kapilnaidu1/phys39-naidu-cohen/data/module_02/README.txt

Module 2 data files.

part3_hbridge_motor.txt
    Records from Part 3 of Module 2: trim pot -> PWM -> BTS7960 H-bridge
    -> DC motor. Contains the computed PWM timebase, the direction
    symmetry test at four fixed knob settings, the speed sweep plateaus
    read off the Serial Monitor with the predicted pulse widths, a note
    on the double quantization in the ADC-to-PWM chain, and what the
    BK Precision 2120B analog oscilloscope traces do and do not
    establish. Produced by arduino/module_02/trimpot_hbridge/trimpot_hbridge.ino
    with maxDuty = 255.
