kapilnaidu1/phys39-naidu-cohen/data/module_03/README.txt

Module 3 data files.

Reserved for the C3 raw data file: the CSV written by the Python strip
chart, with column headings time_s, temperature_C, pwm, heat_cool, plus
the labeled heating and cooling serial records.
