kapilnaidu1/phys39-naidu-cohen/data/module_01/README.txt

Module 1 data files.

ave_data.txt
    Raw Serial Monitor capture from code/module_01/averaging_compare.ino,
    Parts 3C and 3D. Potentiometer parked on the ADC code 863/864 boundary.
    Contains the complete 100-point Ave1 block, the complete 100-point
    Ave1000 block, and the timing lines that bracket them, plus the
    code-512 observation discussed in section 4.5 of the evidence note.
