kapilnaidu1/phys39-naidu-cohen/data/module_08/bench_log_2026-10-28.md

# Bench log, 28 October 2026: rod instrument, first step and steady profile

Naidu. `python3 python/rod_pi_logger.py`, sketch
`arduino/module_08/rod_tec_multichannel`, PI Kp 12, Ki 0.2, anti-windup on,
PWM limit 255. Base thermistor on A0, rod thermistors R1 to R5 on A1 to A5,
100 kOhm fixed resistors. Calibration offsets from
26 October (`calibration_rod_run_20261026_112627.csv`). Times are Arduino
seconds within each file.

## Runs

| File | What happened |
|---|---|
| `rod_run_20261028_090604` | 213 s, control off, room readings while the sensors settled. |
| `rod_run_20261028_091129` | Baselines noted at 85 s and 303 s. Control was ticked on at 40 °C three times (486, 494, 514 s) and switched off within 1 s each time: the base reading dropped out (86 rows with no base value) and the logger turns control off when the base reading is unusable. Logger restarted. |

Earlier that morning the base thermistor had been in a rod hole; it was moved
back into the plate hole below the foam before the main run.
| `rod_run_20261028_092033` | The main run, below. |

## Run 092033 (started 09:20:33)

| Arduino time (s) | Event |
|---|---|
| 13 | note "baseline"; control off, all sensors at room temperature |
| 87 | PI on, setpoint 40 °C (old tape order, see below) |
| 602 | control off; first step not stationary (R5 still rising) |
| 1319 | note "baseline 3"; rod re-taped so R1 is in the lowest rod hole (course Part 2) |
| 1544 | PI on, setpoint 20 °C |
| 1608 | note "hold 20 C, new order: R1 lowest hole (x=0), R2-R5 up the rod" |
| 2440 | note "cal check 20 C, rod drifting 0.02-0.05 C/min" |
| 2556 | setpoint 20 → 45 °C (note typed at 2567) |
| about 3440 | hands and a ruler near the rod while measuring the hole spacing; R1 dipped 0.4 °C (note at 3645) |
| 4647 | control off, logger closed |

**Sensor maps.** 0 to 602 s used the old tape order:
`sensor_map_rod_run_20261028_092033.csv`. From 1319 s: `sensor_map.csv` (R1
in the first rod hole = x = 0, R2 to R5 up the rod). The `_meta.json` of this
run holds the sensor map as it was at 09:20 (positions blank), so the two
files above are the record.

**Room temperature.** 13 to 87 s: the five rod channels read 21.03 °C (sd
0.02 °C) after offsets; base 20.98 °C. No room reading at the end.

**Positions.** Measured with a tape after the run: the holes holding R1 to
R5 are 1 in (25.4 mm) apart, ±1 mm. The farthest hole is about 4 in beyond R5
and R1's hole to the rod top about 11 in (rough). **To do: rod diameter with
calipers, a room-temperature reading at the end of a hold, photograph.**

## Results

- Step response: `data/module_08/step_rod_run_20261028_092033_t1319-4646.txt`
  and the figure of the same name. Non-oscillatory base step (peak
  45.07 °C); R1 to R5 rise 17.5, 16.3, 14.8, 13.6 and 12.8 °C with arrival
  times 6, 10, 15, 21 and 28 s.
- Steady profile (last 300 s): m = 4.12 ± 0.07 m⁻¹ (finite, insulated tip, χ²/dof 3.5),
  θ5/θ1 = 0.74. The course placement target θ5 ≤ θ1/e is **not met**, and
  the fit predicts 0.60 at the farthest hole. Details:
  `docs/module_notes/module_08_stationary_fin.md`.
- Raised with Prof. Fraden: spread the sensors to the farthest hole and accept
  about 0.6, or change the set-up (insulation or air around the rod).
