kapilnaidu1/phys39-naidu-cohen/data/module_06/bench_log_2026-10-19.md

# Bench log, 19 October 2026: foam box off and on

Naidu. One GUI session, `python3 python/tec_pi_control_gui.py`, with
`arduino/module_06/tec_pi_safety` on the board (readings every 0.56 s, as on 13
and 14 October). File:
`pi_run_20261019_105852.csv` (GUI launched 10:58:52). Water loop and 12 V
supply on. Anti-windup on, PWM limit 255, run label 0 throughout. Times below
are GUI time (the `time_s` column).

Purpose: the foam-removal experiment designed in
`docs/module_notes/module_06_oral_review.md`, section 6. The plan was three
blocks (foam off, on, off); only two were run because of time.

| GUI time (s) | Foam | Setting | Notes |
|---|---|---|---|
| 0 to 40 | off | control off | plate 22.3 °C at the start, rising slowly |
| 40 to 315 | off | PI, Kp 12, Ki 0.2, 30 °C | |
| 316 to 678 | off | PI, 45 °C | |
| 678 to 1028 | off | control off | passive cool-down, about 350 s |
| 1028 to 1338 | off | P, Kp 2, 35 °C | |
| 1338 to 1401 | fitted | control off | foam box put on |
| 1401 to 1612 | on | PI, Kp 12, Ki 0.2, 30 °C | |
| 1613 to 1737 | on | PI, 45 °C | shorter than planned (about 2 min) |
| 1738 to 1891 | on | control off | cool-down, shorter than planned (about 150 s) |
| 1891 to 2220 | on | P, Kp 2, 35 °C | |
| 2220 | on | control off, GUI closed | third block (foam off) not run |

Analysis: `python3 python/foam_experiment_analysis.py`, output in
`data/module_06/foam_experiment_output.txt`.
