kapilnaidu1/phys39-naidu-cohen/data/module_06/bench_log_2026-10-13.md

# Bench log, 13 October 2026

## Setup

- Uploaded `arduino/module_06/tec_pi_safety`. Boot banner confirms 1000 ADC
  readings per temperature. Readings arrive every 0.56 s (median dt 0.560 s,
  range 0.560 to 0.610 s in the run file), not 0.50 s.
- Plate at PWM 0 before any drive: 22.38 C at first upload, 22.0 C after the
  second reset. Module 4 measured 21.54 C.
- TEC on-state voltage: **not measured.** The multimeter gave no reading at
  PWM 255. The instructor checked the setup and said to use the 12 V maximum
  and move on to the experimental runs. Simulations use V_TEC = 12 V on that
  basis.
- While trying to measure it, COOL 255 was held for about 37 s: the plate went
  from 22.00 C to -1.58 C, then recovered passively for 18.6 s to 5.84 C.
  Raw output: `serial_2026-10-13_cool255_burst.txt`.

## Instructor

- Reviewed the PI code in `python/tec_pi_control_gui.py`.
- TEC voltage: use 12 V (above).
- Said not to redo the Module 4 measurements: keep the existing tau, which
  came from 500-sample data, and use 1000-sample averaging from now on.

## Goldilocks runs

All six in `pi_run_20261013_094149.csv`, one GUI session (`python/tec_pi_control_gui.py`).
Same for every run: setpoints 30 and 35 C, PWM limit 255, anti-windup on,
integral zeroed before each run. Each run starts from wherever the plate was
after control was switched off, settles at 30, steps to 35, steps back to 30.
"Settled" is the mean of the last 30 s of each stage.

| Run | Mode | Kp | Ki | Start (C) | Settled at 30 / 35 / 30 (C) | Peak or dip |
|---|---|---|---|---|---|---|
| 1 | P | 2 | 0 | 21.15 | 25.76 / 28.25 / 25.76 | none |
| 2 | P | 16 | 0 | 23.41 | 29.05 / 33.52 / 29.12 | none |
| 3 | P | 64 | 0 | 23.94 | 29.74 / 34.59 / 29.76 | 31.55, 36.28, dip 29.69; rings |
| 4 | PI | 12 | 0.05 | 23.08 | 29.66 / 34.71 / 30.08 | none; still creeping after 300 s |
| 5 | PI | 12 | 0.2 | 24.72 | 29.97 / 35.02 / 29.93 | 35.04, dip 29.91 |
| 6 | PI | 12 | 1.0 | 24.95 | 30.00 / 35.00 / 30.00 | 30.59, 35.71, dip 28.70 |

Run 3 hit the +255 and -255 limits briefly on each step (11 saturated rows).
No other run saturated.

## Not part of the six runs

From 3750 s to 3941 s, still labelled run 6, the instructor had us try
Ki = 2, 5 and 10 at Kp = 12 as a spot check. These rows are identified by their
`ki` column and are not retained Goldilocks data. Largest swings: 37.99 C at
Ki = 5 after a step to 35, and 25.51 C at Ki = 10 after a step to 30.
