kapilnaidu1/phys39-naidu-cohen/docs/assessments/a2_open_loop_tec.md

# A2: TEC Heating and Cooling Analysis

**Team:** Naidu / Cohen
**Due:** Wednesday 7 October 2026, 6:00 PM (moved from 5 October by email,
30 September)
**Submit:** `docs/A2_Naidu_Cohen.pdf`, two pages, each of us uploads it
separately to Moodle
**Repository file:** none required. No Git checkpoint for this one.

Working note: [`docs/module_notes/module_04_open_loop_tec.md`](../module_notes/module_04_open_loop_tec.md)

> **Do NOT include** C2/C3 circuit sketches, apparatus descriptions, the
> safety demonstration, or code documentation. Those live in the module note
> and stay there. A2 is analysis only.

The assignment was restructured on 30 September. It now asks for **six numbered
sections using the course page's own headings**, and the 100 to 150 word
conclusion is **no longer required**. The PDF follows those headings exactly,
including the two sections both numbered Part 5.4, since both come from Part 5
subsection 4 of the module.

| Section heading in the PDF | Rubric | Points |
|---|---|---|
| Part 4: Combined graph and fits | items 1-2 | 2 |
| Part 5.1: Measured slopes | items 1-2 | (same 2) |
| **Part 5.2: PWM and the slope-ratio model** | item 3 | **3** |
| Part 5.3: Laird data-sheet calculation | item 4 | 2 |
| Part 5.4: Compare the ratios | items 5-6 | 2 |
| Part 5.4: Passive conduction | items 5-6 | (same 2) |
| Concise, legible, complete | | 1 |

The derivation carries the most weight of any single item.

---

## 1. The graph *(2 pts, shared)*

Part 4 figure: steady-state temperature versus **signed PWM**, heating red
and cooling blue as separate data sets, **with fitted lines over the ranges
used**, labelled axes, units, and a caption stating how steady state was
chosen.

Generated by `python/plot_open_loop_calibration.py` into
`docs/figures/module_04/`.

*Status: waiting on Part 3 data.*

## 2. Slopes, units, ratio *(2 pts, shared)*

| | value | fit range | R squared |
|---|---|---|---|
| m_h | TO RECORD C per PWM count | | |
| m_c | TO RECORD C per PWM count | | |
| r = m_h / m_c | TO RECORD | | |

Note any visible curvature.

## 3. The derivation *(3 pts, the heaviest item)*

Three things, all required:

**(a) PWM average-current proof.** From the definitions of the averages over
one period, with current I for D*tau and zero otherwise, show
`<I> = D I` and `<I^2> = D I^2`. Explain why `<I^2>` is not `<I>^2`, and
connect it to the measured susceptibility: Peltier follows `<I>` and Joule
follows `<I^2>`, both linear in D under PWM, so the susceptibility is
approximately constant and the graph roughly straight.

**(b) Steady-state slope derivation.** From `C dT/dt = Q_TEC - G(T - T0)` at
`dT/dt = 0`, with `Q_TEC = d Qp + |d| Qj`, obtain

```
dTh/dd = (Qp + Qj)/G        dTc/dd = (Qp - Qj)/G
```

and hence, the 1/255 cancelling from the ratio,

```
Qj/Qp = (r - 1)/(r + 1)
```

**(c) Numerical result.** Evaluate `Qj/Qp` from the measured r. Check: r = 2
gives exactly 1/3.

Full working is in section 5 of the module note.

## 4. Laird data sheet *(2 pts)*

Source: **Laird CP14-127-045-L2-W4.5**, MFG part 58910-501, SPECIFICATIONS
table, **Hot Side Temperature = 27.0 C** column.

| Quantity | Value | What it means, and the condition attached |
|---|---|---|
| `R_M` | **1.50 ohm** | Ohmic resistance of the 127 couples in series. Quoted at Th = 27 C; it rises with temperature (1.56 at 35 C, 1.68 at 50 C on the same sheet) |
| `I_max` | **8.6 A** | The current that produces the **largest temperature difference**, not a safety ceiling. Condition: I at dT_max |
| `Qc_max` | **71.3 W** | Most heat the cold face can absorb. Condition: **dT = 0**, so the module is pumping with no temperature difference to fight |
| `dT_max` | **70.5 C** | Largest temperature difference the module can sustain. Condition: **Qc = 0**, no heat load at all |

`Qc_max` and `dT_max` sit at opposite ends of one trade-off: maximum pumping
needs zero temperature difference, maximum difference needs zero load. The
module never delivers both.

### Calculation

At the data-sheet condition dT = 0, so the conduction term vanishes. The
symmetric model puts half the Joule heat on each face:

```
Qj_max = 0.5 * I_max^2 * R_M
       = 0.5 * (8.6 A)^2 * 1.50 ohm
       = 55.47 W

Qp_max = Qc_max + Qj_max
       = 71.3 W + 55.47 W
       = 126.77 W

r_Laird,max = (Qp_max + Qj_max) / (Qp_max - Qj_max)
            = (126.77 + 55.47) / (126.77 - 55.47) W/W
            = 2.556
```

### Data-sheet check

**Verified against the data sheet, 5 October.** All four values, plus
V<sub>max</sub> = 13.9 V and the 35 and 50 &deg;C resistances, were read again
from the course-hosted PDF and match. The SPECIFICATIONS table is on **page
3** of the three-page sheet.

**A cross-check that was here has been withdrawn.** It computed a Seebeck
coefficient from V<sub>max</sub> = I<sub>max</sub>R<sub>M</sub> +
S&middot;&Delta;T<sub>max</sub>, using R<sub>M</sub> = 1.50 &Omega;. But 1.50
&Omega; is the resistance with the whole module at 27 &deg;C, and
V<sub>max</sub> is quoted at &Delta;T<sub>max</sub>, where the cold face is
near &minus;44 &deg;C and the module averages about &minus;8 &deg;C. The sheet
gives no resistance at that temperature, and the answer depends heavily on it:
1.50 &Omega; gives S = 0.014 V/K, while a straight-line extension of the
sheet's own 27 to 50 &deg;C trend down to &minus;8 &deg;C (an assumption, for
illustration only) gives 1.22 &Omega; and S = 0.048 V/K. A check that moves by
a factor of three with an unknown input cannot confirm anything, and the
earlier claim that 0.014 V/K was "reasonable" for 127 couples was not
supported.

## 5. Comparison *(part of 2 pts with item 6)*

| | r | Qj/Qp |
|---|---|---|
| **measured** | **2.771** | **0.470** |
| **Laird, at I_max** | **2.556** | **0.438** |
| ratio | 1.084 | |

**Agreement to 8%**, which is closer than this comparison has any right to be,
and the write-up should say so rather than claim a prediction confirmed.

**Why they should not be expected to match.**

- **D = 1 does not mean I = I_max.** Full duty only means the bridge is
  continuously on. The actual current is set by the supply voltage, the
  H-bridge drop, wiring resistance, `R_M` and the module's own back-EMF. The
  supply is rated 12 V with no adjustable current limit; its measured voltage
  was not written down. 12 V across R_M = 1.50 ohm gives **at most about
  8.0 A**, 7% below I_max, and less once the other drops are included. So full
  duty does not reach I_max, but the margin set by the supply alone is small,
  and **the bench current was never measured**. An earlier version said "well
  under 8.6 A" using a 1.6 ohm figure taken from the withdrawn Seebeck
  cross-check; that was not supported.
- **PWM, not steady DC.** Our current is chopped. Section 3a shows the
  cycle averages are `<I> = DI` and `<I^2> = DI^2`, so the Peltier and Joule
  contributions scale together with duty; the data sheet assumes a steady
  current.
- **Finite dT.** The data-sheet relation is stated at `dT = 0` where
  conduction through the module is zero. Our plate ran 25 C above and 12 C
  below ambient, where that term is not negligible and is lumped into `G`.
- **Material properties move with temperature.** The same sheet shows `R_M`
  rising from 1.50 to 1.68 ohm between 27 and 50 C.
- **One slope fitted to each branch.** R^2 is 1.0000 and 0.9989, so this is a
  small effect here, but the fit still averages over a range where the
  coefficients are not strictly constant.

**Direction of the difference.** Our `Qj/Qp` is the larger. That is what you
expect when running below `I_max`: Peltier pumping falls linearly with
current while the Joule term falls as the square, but the *ratio* `Qj/Qp`
goes as `I`, so operating below `I_max` should actually reduce it. The fact
that ours is instead slightly higher points at the extra dissipation our
model lumps into the object face that the data sheet does not carry, such as
lead and contact resistance in series with the module.

## 7. Conclusion, 100 to 150 words *(1 pt with formatting)*

> Steady-state temperature is linear in signed PWM on both branches
> (R^2 = 1.0000 heating, 0.9989 cooling), which is what the PWM averages
> predict: Peltier transport follows `<I> = DI` and Joule heating follows
> `<I^2> = DI^2`, so both scale with duty and the susceptibility stays
> constant. Had `<I^2>` gone as `D^2`, the branches would curve. The two
> slopes differ by a factor r = 2.771 because reversing the current reverses
> Peltier pumping but not Joule heating: the two add when heating and oppose
> when cooling, giving `Qj/Qp = (r-1)/(r+1) = 0.470`. Passive conduction
> enters both branches through the same `G` and cancels from the ratio, so it
> sets how steep the lines are but cannot make them unequal. The Laird
> maximum-current figures predict r = 2.556, within 8% despite describing a
> steady-DC, zero-dT condition our apparatus never reaches.

**146 words.** Edit freely; it's meant as a starting draft, not a final voice.

Every claim in it traces to something in the paper above: the two R^2 values
from item 1, r and Qj/Qp from items 2 and 3, the cancellation argument from
item 6, and the 8% from item 5.

## Assembly

1. Fill `data/module_04/steady_state.csv`
2. `python3 python/plot_open_loop_calibration.py` from the repo root
3. Read the Laird values off the data sheet
4. `python3 python/build_a2_pdf.py`, which writes `docs/A2_Naidu_Cohen.pdf`
5. Both of us upload it to Moodle separately
