kapilnaidu1/phys39-naidu-cohen/docs/A2_Naidu_Cohen.pdf

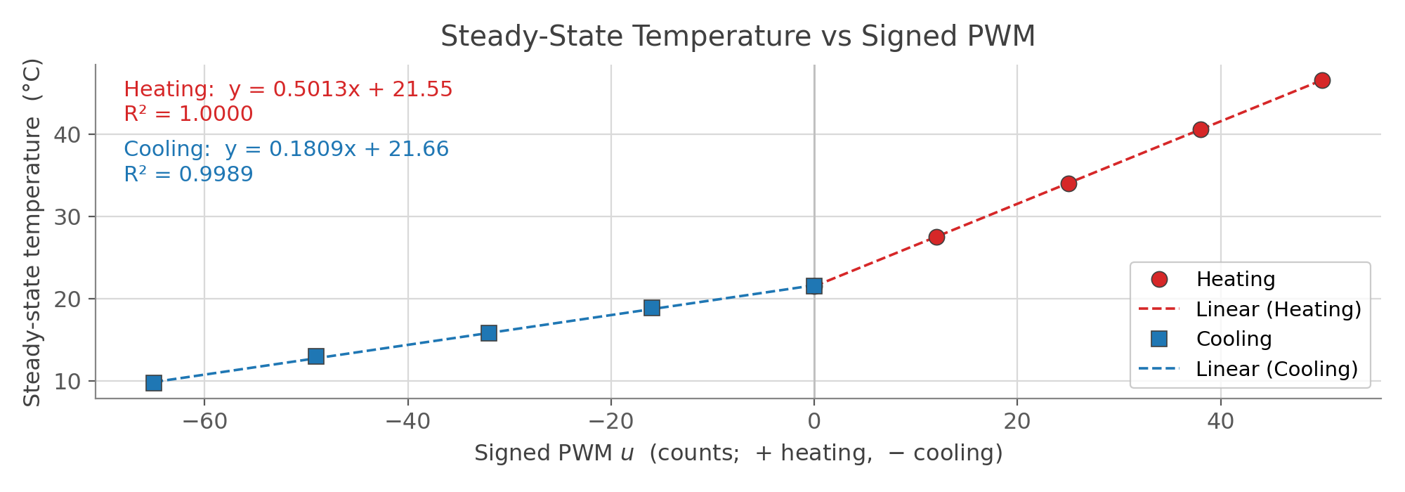
[picture p46: figure]

1 / 2

# A2: TEC Heating and Cooling Analysis

Assessment code: A2
Team members: Kapil Naidu and Samuel Cohen
Date: September 30, 2026 (data collection)
Repository: https://github.com/kapilnaidu1/phys39-naidu-cohen, branch main

## Part 4: Combined graph and fits

Figure 1. Steady-state plate temperature against the signed PWM command u, positive for heating and negative for cooling, with both branches on one graph. Ten points, five per branch, about the zero-command temperature T0

= 21.54 °C. Each trendline is drawn only over the PWM range used for its own fit: u = 0 to +50 counts for heating, u = −65 to 0 counts for cooling. Steady-state criterion: after each step the trace was watched for about three driven time constants (τ ≈ 70 s) plus one further minute, and the point was accepted once its net drift over that minute was no larger than the measured noise of 0.16 °C peak to peak. Points that had not fully arrived are reported as the asymptote of an exponential fit, and data/module_04/steady_state.csv records which.

## Part 5.1: Measured slopes

Branch | Susceptibility dT/du | Fit range (counts) | 2 R | Intercept
Heating | mh = 0.5013 °C per PWM count | u = 0 to +50 | 1.0000 | 21.55 °C
Cooling | mc = 0.1809 °C per PWM count | u = −65 to 0 | 0.9989 | 21.66 °C

Against signed u both slopes are positive, so the cooling entry is already the magnitude |χ

T,c|. The ratio is r = mh
/ mc

=
0.5013 / 0.1809 = 2.771, dimensionless because both slopes carry the same units.
Curvature and choice of fit range. Neither data set shows visible curvature, so each branch was fitted over its full measured range rather than a restricted sub-range; the ranges above are simply the PWM values used in Part 3. The branches are fitted separately because the slope changes abruptly at u = 0, not because either bends. The intercepts differ by 0.11 °C and the cooling one sits 0.12 °C above T0

, consistent with the room drifting over a two-hour session.

## Part 5.2: PWM and the slope-ratio model

Step 1. The steady-state balance
With C the heat capacity of the object and G the effective passive conductance to the room, C dT/dt = QTEC − G(T − T0

). At
steady state dT/dt = 0, so the individual flows are not zero but their sum is, and G(T − T0

) = QTEC. Taking the two terms in turn: heating, Peltier transport and Joule dissipation both carry heat into the object while conduction carries heat out of it to the cooler room; cooling, Peltier transport carries heat out of the object, Joule dissipation still carries heat into it, and conduction carries heat into it from the warmer room.
Step 2. PWM current averages
Over one PWM period τ the bridge delivers the on-state current I for a time Dτ and zero for the remaining (1−D)τ, with duty D = |u| / 255. Both integrands vanish outside the on-interval, so each integral is just the integrand times Dτ:
<I> = (1/τ) ∫0

τ
I(t) dt = (1/τ) · I · Dτ = D I <I

2
> = (1/τ) ∫0

τ

I²

(t) dt = (1/τ) · I²
- Dτ = D I²

<I

2> is not <I>

2

= D²
I

2
: squaring and averaging do not commute, and for a two-level waveform the two differ by a factor 1/D. Peltier transport follows <I> and Joule heating follows <I

2>, and under PWM both are linear in D, so the susceptibility is constant and the branches are straight. Had the Joule term gone as D² the susceptibility would vary with duty and the branches would curve measurably; the measured R²
of 1.0000 and 0.9989 says they do not. With a DAC supplying a steady current of variable amplitude instead, <I

2> = <I>

2
would hold, so the distinction is a property of PWM.

2 / 2

Step 3. The slope ratio
With signed duty d = u / 255 and D = |d|, Peltier transport reverses with the current and Joule heating does not, so QTEC = d QP

+ |d| QJ
. Substituting each branch into G(T − T0

) = QTEC and differentiating with respect to d: heating, d > 0: G(Th
− T0

) = d(QP
+ QJ
) | → | Th

− T0

= d(QP
+ QJ
)/G | → | dTh

/dd = (QP
+ QJ

)/G
cooling, d < 0: G(T
c

− T0

) = d(QP
− QJ
) | → | T
c

− T0

= d(QP
− QJ
)/G | → | dT
c

/dd = (QP
− QJ

)/G

Both are positive while QP
> QJ

, and the heating one is larger. Since d = u / 255, each measured slope carries the same factor 1/255, and that factor and G are common to both branches, so both cancel from the ratio: r = mh

/m
c

= (QP

+ QJ

) / (QP

− QJ

) | ⇒ | QJ

/QP

= (r − 1)/(r + 1) | check: r = 2 gives 1/3 exactly
r = 2.771: | QJ

/QP

= (2.771 − 1) / (2.771 + 1) = 1.771 / 3.771 = 0.470

Joule heat reaching the object face is 47.0% of the Peltier pumping. Both are heat rates in watts, so the ratio is dimensionless. G cancels from r, which matters because G was never measured.

## Part 5.3: Laird data-sheet calculation

Source. Laird CP14-127-045-L2-W4.5, MFG part 58910-501, from the SPECIFICATIONS table on the first page of the CP14-127-045 data sheet, hot-side temperature Th

= 27.0 °C column.

Quantity | Value | Meaning, and the operating condition attached
RM | 1.50 Ω | Ohmic resistance of the 127 couples in series, quoted at Th = 27 °C and rising to 1.68 Ω at 50 °C
Imax | 8.6 A | The current giving the largest temperature difference, not a safety ceiling. Condition: I at ΔTmax
Qc,max | 71.3 W | Most heat the cold face can absorb. Condition: ΔT = 0, no difference to pump against
ΔTmax | 70.5 °C | Largest sustainable temperature difference. Condition: Qc = 0, no heat load

The last two sit at opposite ends of one trade-off: maximum pumping needs zero temperature difference, maximum difference needs zero load. At the data-sheet condition ΔT = 0, so conduction through the module vanishes and the symmetric model puts half the Joule heat on each face:
Q

J,max = ½ I
max

2
RM

= ½ (8.6 A)²

(1.50 Ω) = ½ (73.96 A²
)(1.50 Ω) = 55.47 W
Q
c,max
= QP,max − QJ,max | → | QP,max = 71.3 W + 55.47 W = 126.77 W
r

Laird,max = (QP,max + QJ,max) / (QP,max − QJ,max) = (126.77 + 55.47) / (126.77 − 55.47) = 182.24 / 71.30 = 2.556

Every quantity above is a heat rate in watts, so rLaird,max is dimensionless and directly comparable with the measured r. Cross-check: Vmax
/Imax

= 13.9 V / 8.6 A = 1.616 Ω, 8% above RM

| | , because at ΔTmax

the module develops a Seebeck back-EMF: Vmax
= Imax

RM

+ S·ΔTmax

| | gives S = 0.0142 V/K, reasonable for 127 bismuth telluride couples. The right rows
were read.

## Part 5.4: Compare the ratios

| r | QJ /QP | Condition
Measured, this apparatus | 2.771 | 0.470 | PWM drive, finite ΔT, current set by the supply and bridge
Laird, at Imax | 2.556 | 0.438 | steady DC at 8.6 A, ΔT = 0
ratio | 1.084 | 1.073 | agreement to 8%

The two agree to 8%, closer than the comparison warrants, since the data-sheet figures describe a condition this apparatus never reaches:
- D = 1 does not mean I = Imax

. Full duty only means the bridge is continuously on. The current is set by the 12 V supply and its limit, the H-bridge forward drop, wiring resistance and RM

, which together hold the bench current well below 8.6 A.
- PWM, not steady DC. The bench current is chopped; the data sheet assumes a steady one.
- Finite ΔT and passive heat paths. The data-sheet relation is stated at ΔT = 0, while the plate ran 25 °C above and 12 °C below ambient. There the module's own conduction and the mounting and air paths are not negligible, and all of them are absorbed into the single G.
- Coefficients move with temperature, and one slope is fitted per branch. RM

rises from 1.50 to 1.68 Ω between 27 and 50 °C, so a single fit averages over a range in which the coefficients are not strictly constant. Direction of the difference. The measured ratio is the larger, yet running below Imax

should reduce QJ
/QP

, since that ratio
scales as I. The opposite sign points to dissipation this model assigns to the object face that the data sheet does not carry, such as lead and contact resistance in series with the module.

## Part 5.4: Passive conduction

When the object is hotter than the room, passive heat flows out of the object. When it is colder, passive heat flows into it. Either way the flow drives the object back toward room temperature, so conduction opposes the TEC on both branches, which is why it enters as −G(T − T0

) with a single positive G. It cannot by itself explain the unequal slope magnitudes. The same G appears in the denominator of both dTh

/dd and dT
c

/dd,
so it sets how steep the branches are, a larger G flattening both, but it cancels exactly from their ratio: a symmetric term cannot produce an asymmetric result. The asymmetry survives only in the numerators, where QJ

is added on the heating
branch and subtracted on the cooling one, because Peltier transport reverses with the current and Joule heating does not.
