kapilnaidu1/phys39-naidu-cohen/docs/figures/module_04/sammy_cohen_tec_run_2026-10-13_segment_slopes.png

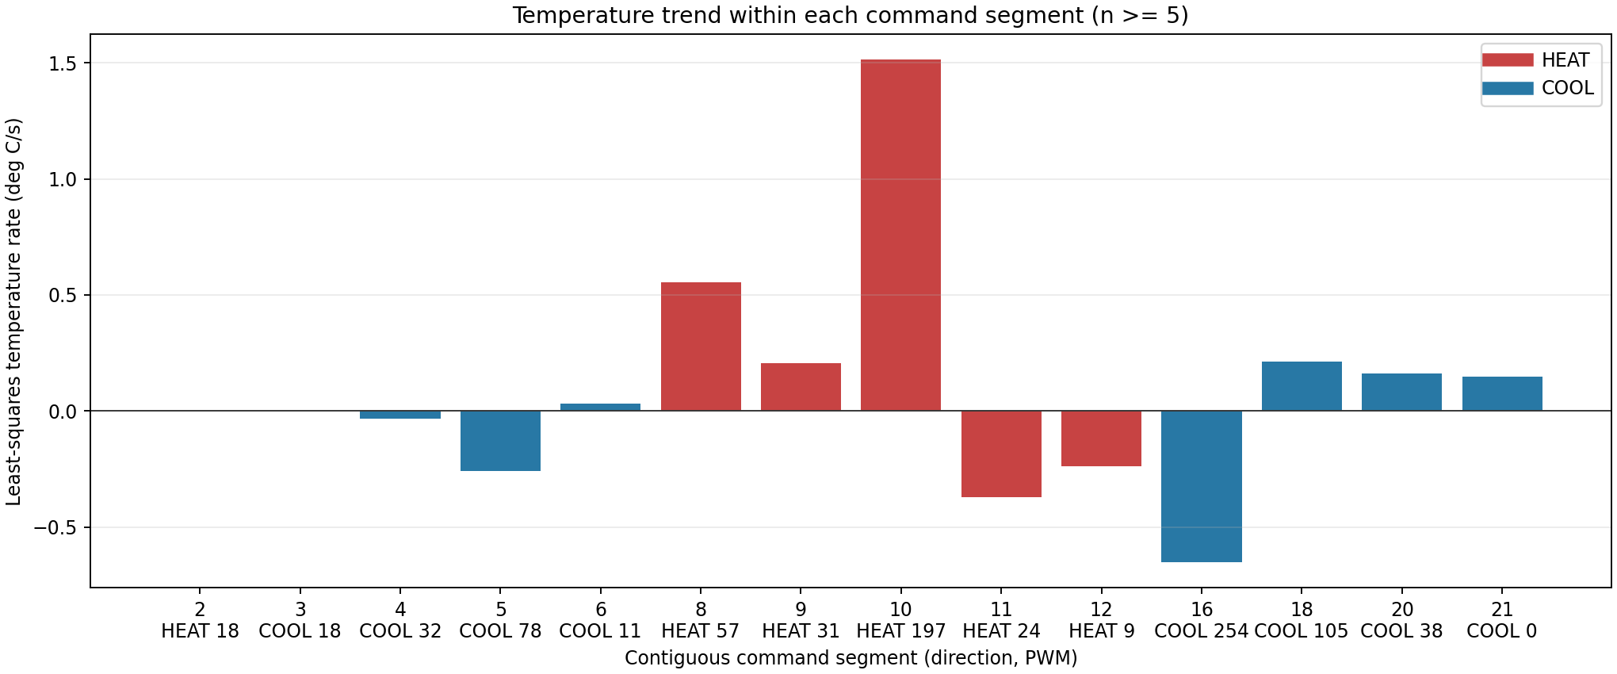
docs/figures/module_04/sammy_cohen_tec_run_2026-10-13_segment_slopes.png
