kapilnaidu1/phys39-naidu-cohen/docs/figures/module_05/p_control_run_2026-10-13_sammy_repeat_timeline.png

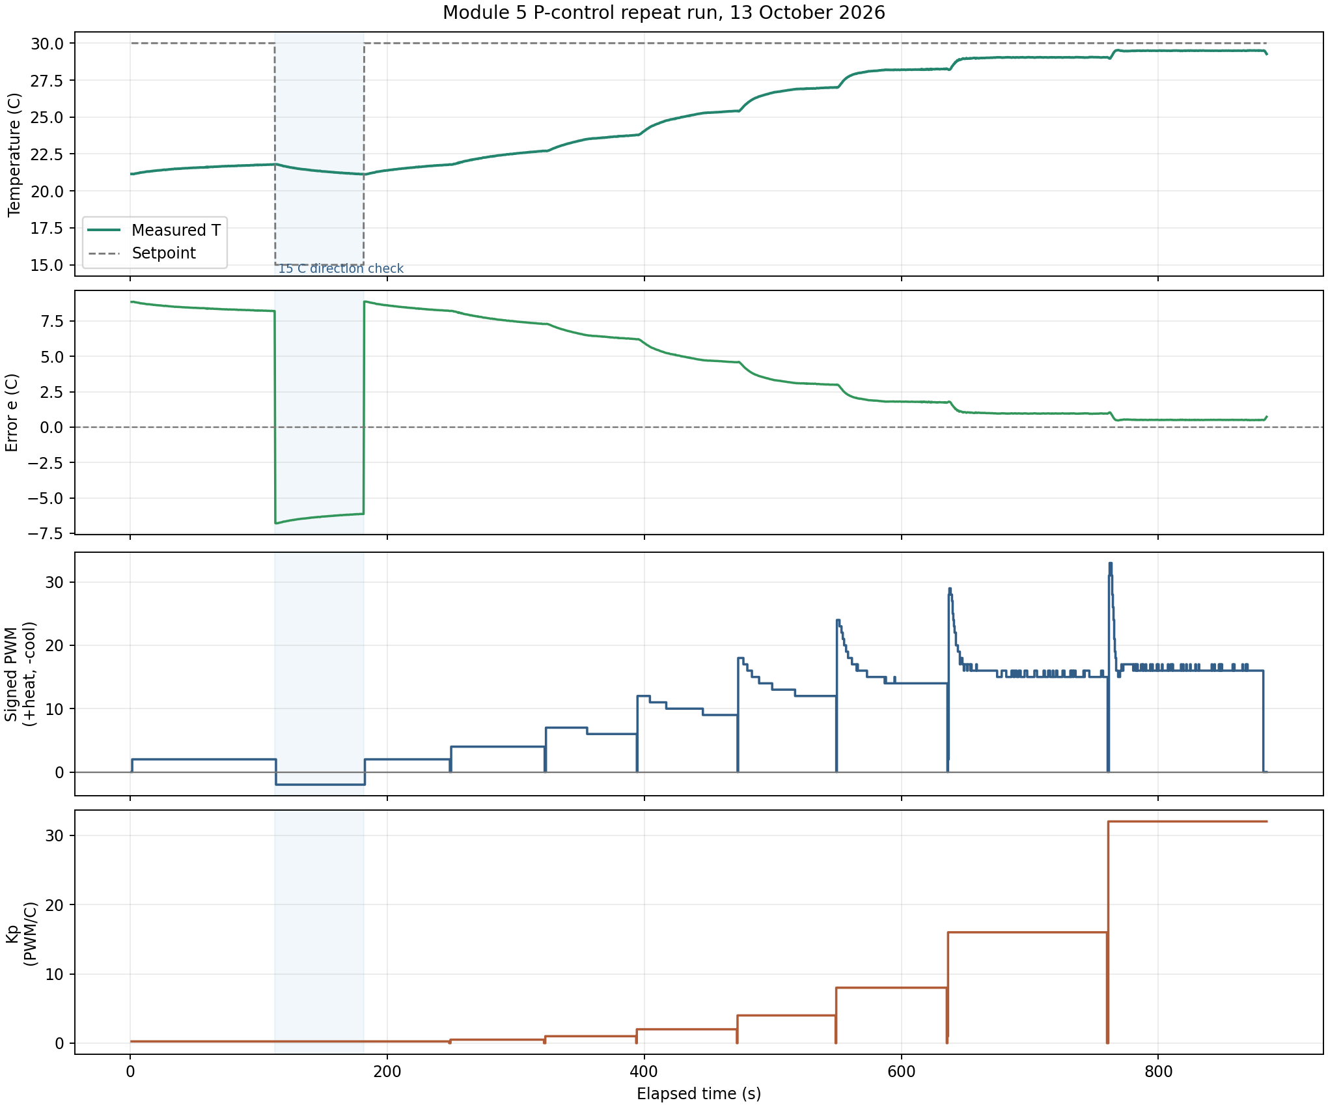
docs/figures/module_05/p_control_run_2026-10-13_sammy_repeat_timeline.png
