kapilnaidu1/phys39-naidu-cohen/docs/figures/module_05/p_control_traces.png

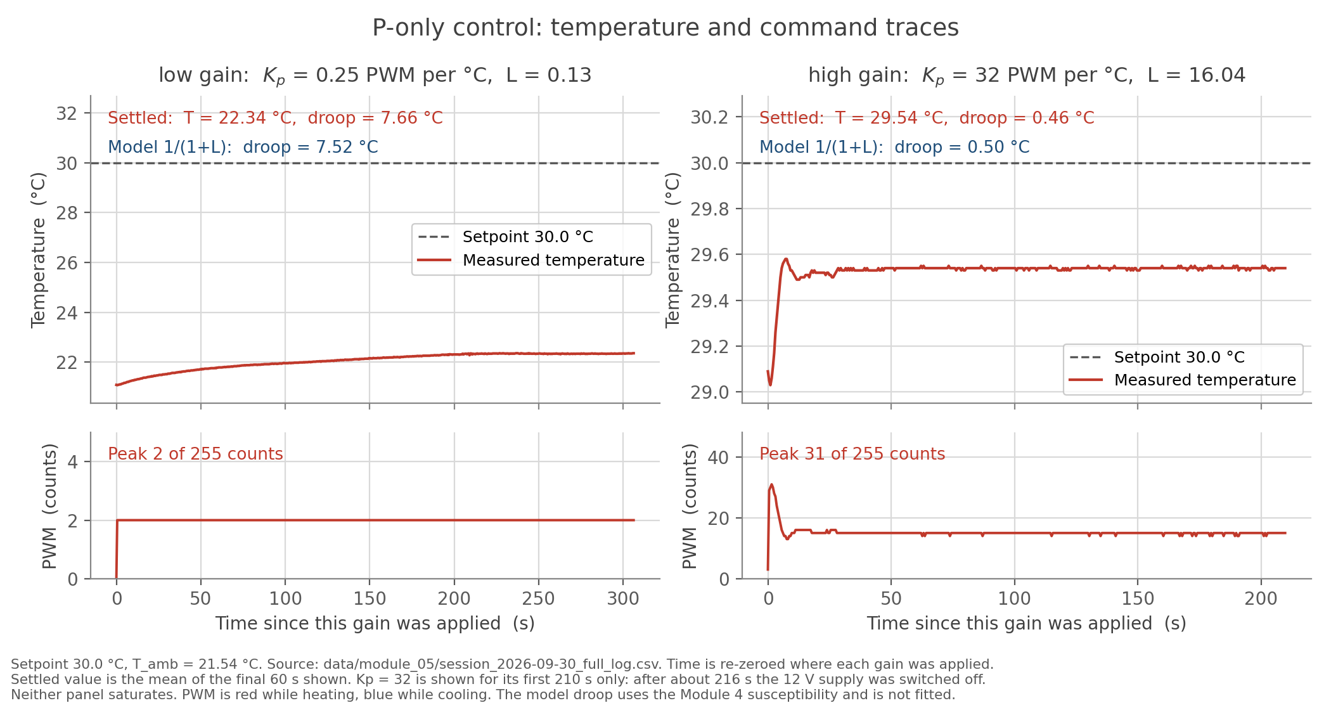
docs/figures/module_05/p_control_traces.png
