kapilnaidu1/phys39-naidu-cohen/docs/figures/module_06/goldilocks/run1_p_kp2.png

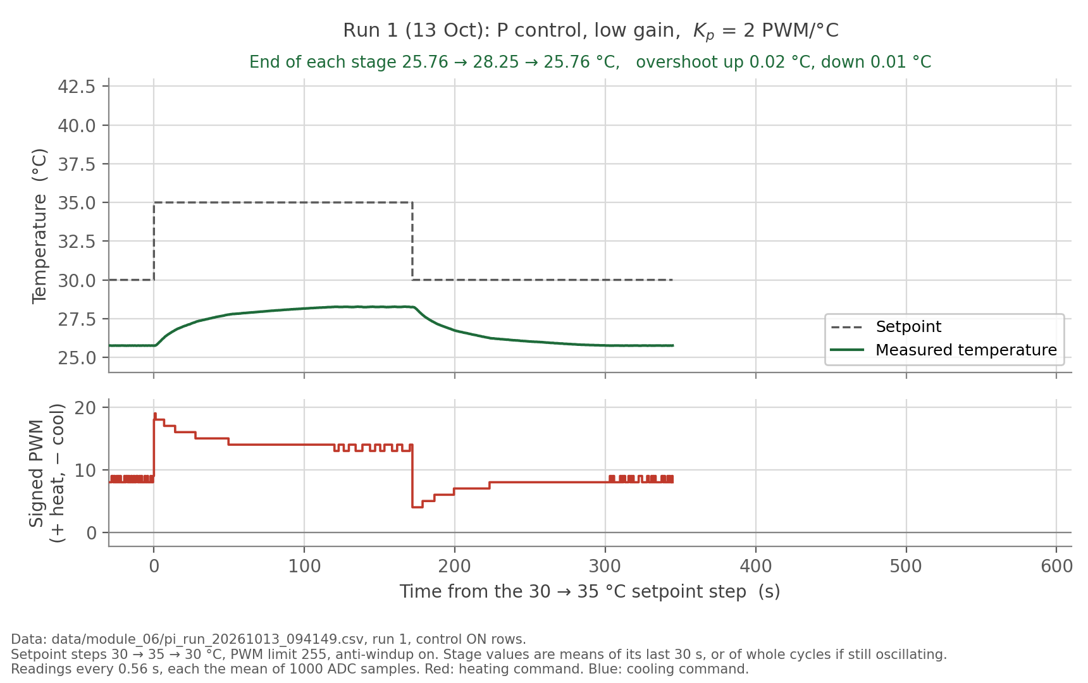
docs/figures/module_06/goldilocks/run1_p_kp2.png
