kapilnaidu1/phys39-naidu-cohen/docs/figures/module_06/goldilocks/run2_p_kp16.png

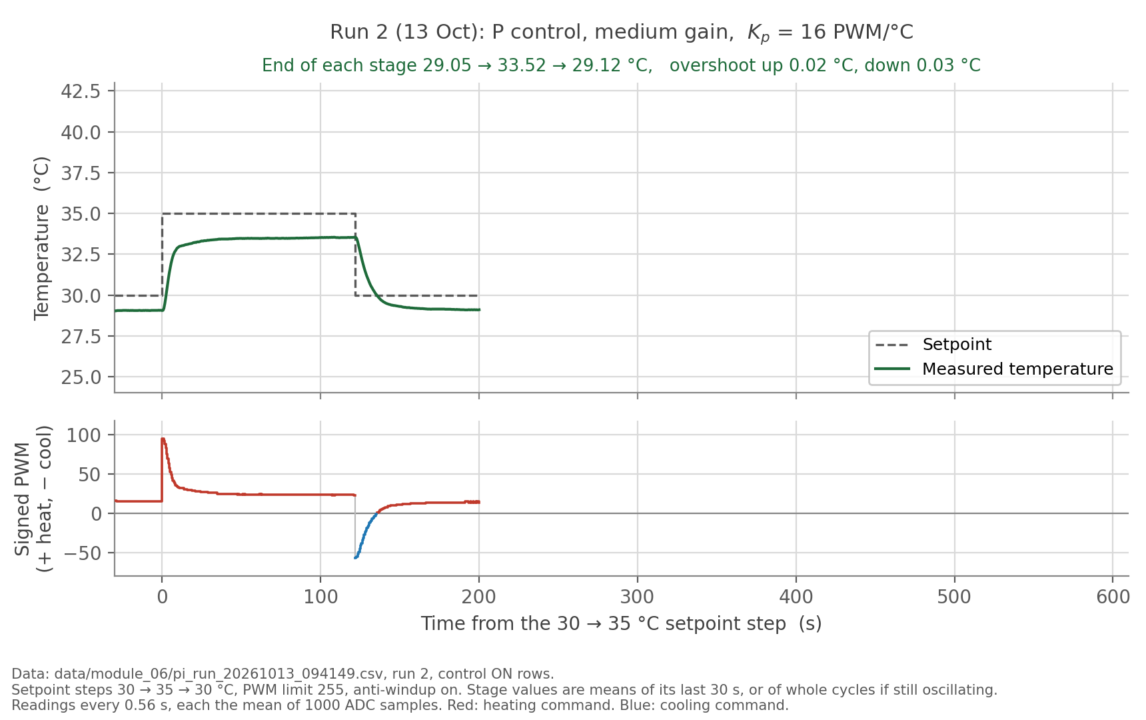
docs/figures/module_06/goldilocks/run2_p_kp16.png
