kapilnaidu1/phys39-naidu-cohen/docs/figures/module_06/goldilocks/run3_p_kp64.png

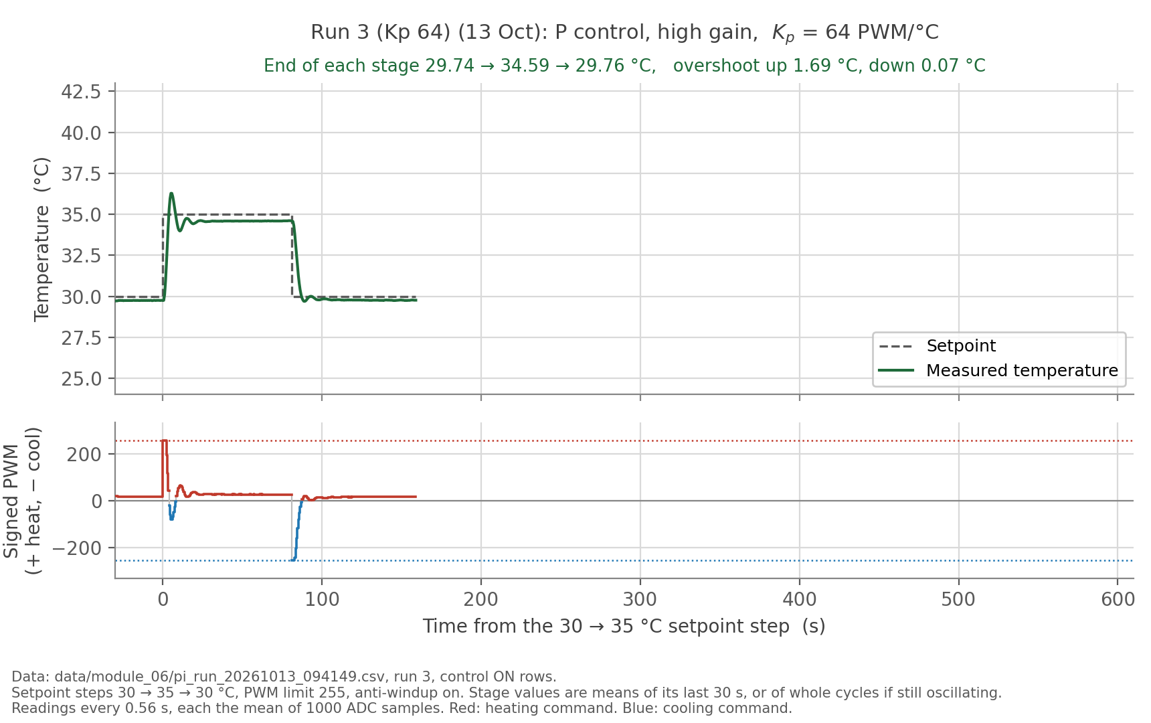
docs/figures/module_06/goldilocks/run3_p_kp64.png
