kapilnaidu1/phys39-naidu-cohen/docs/figures/module_06/goldilocks/run4_pi_ki0p05.png

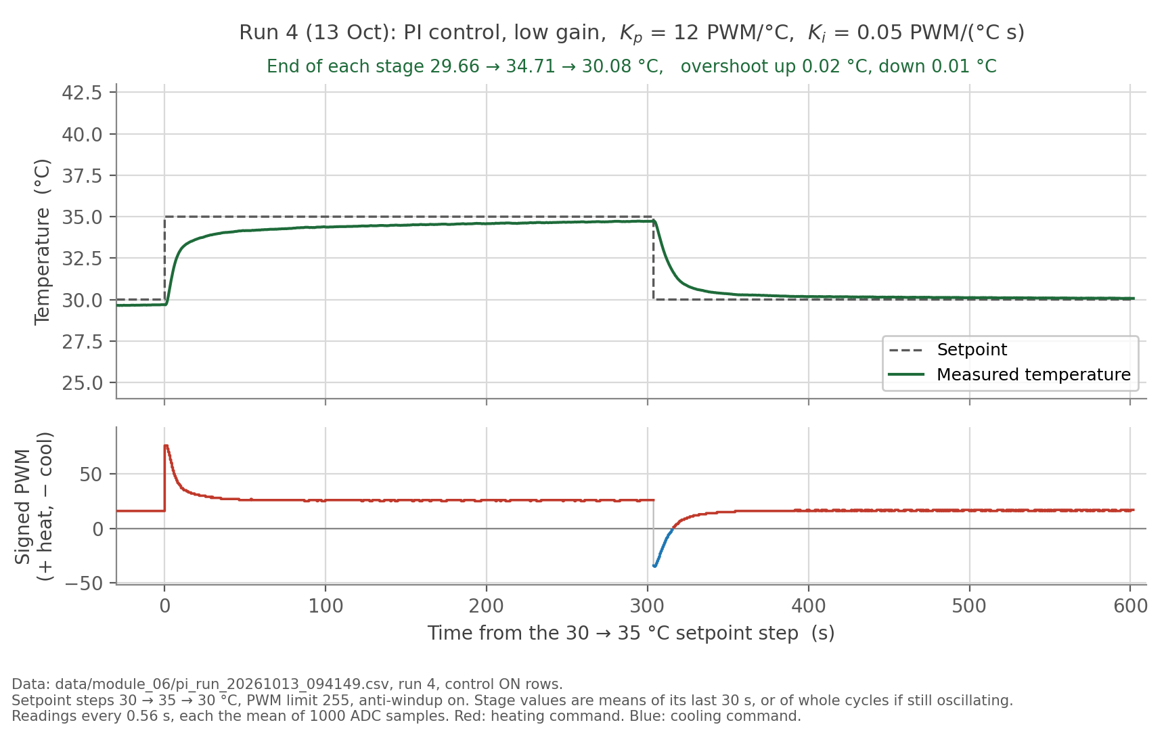
docs/figures/module_06/goldilocks/run4_pi_ki0p05.png
