kapilnaidu1/phys39-naidu-cohen/docs/figures/module_06/goldilocks/run5_pi_ki0p2.png

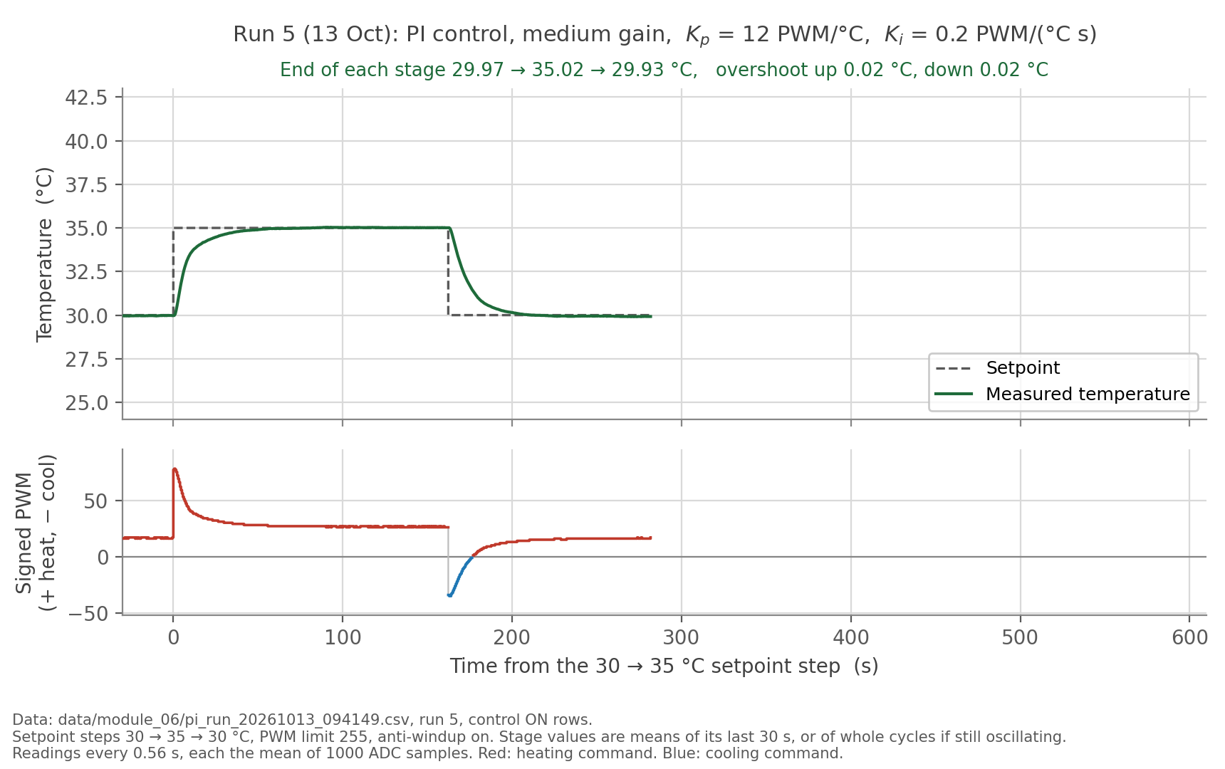
docs/figures/module_06/goldilocks/run5_pi_ki0p2.png
