kapilnaidu1/phys39-naidu-cohen/docs/figures/module_06/goldilocks/run6_pi_ki20.png

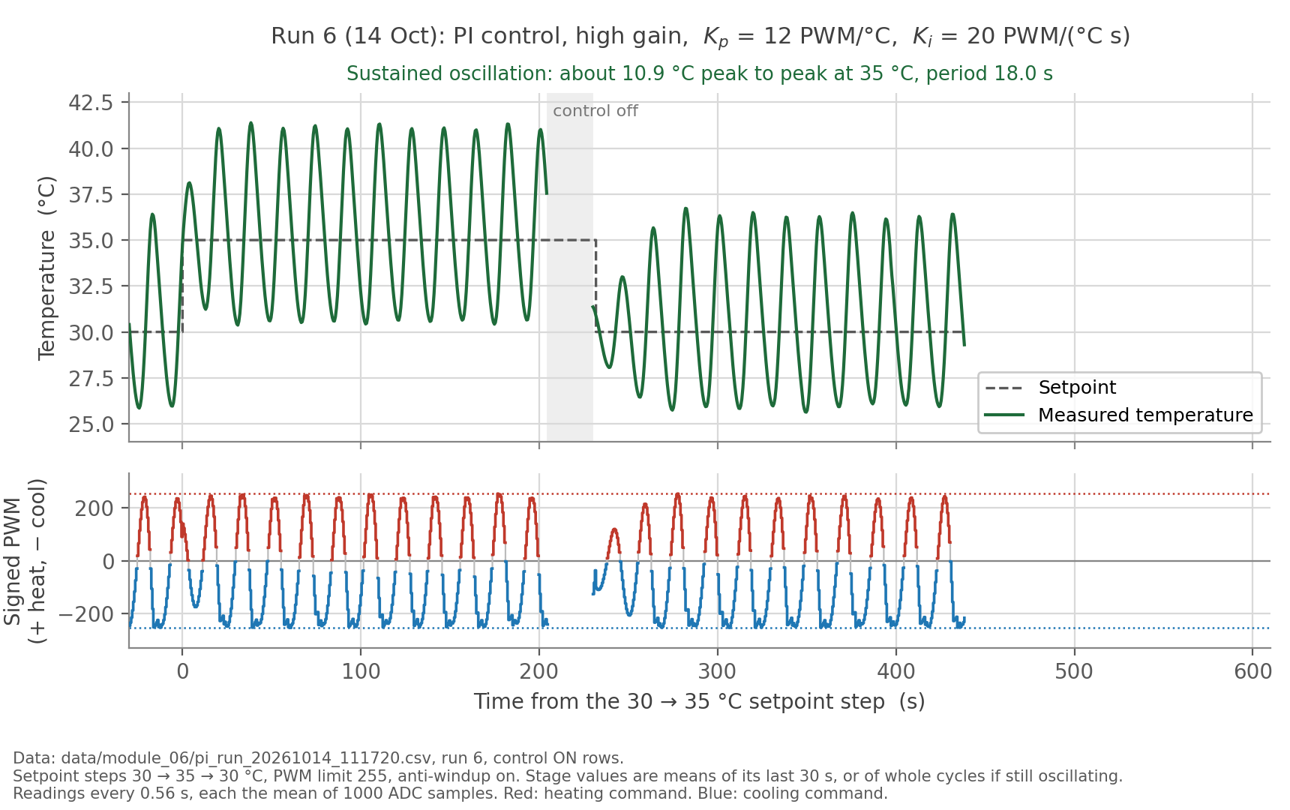
docs/figures/module_06/goldilocks/run6_pi_ki20.png
