kapilnaidu1/phys39-naidu-cohen/docs/figures/module_06/goldilocks_sim/overlay_p_and_pi_sim.png

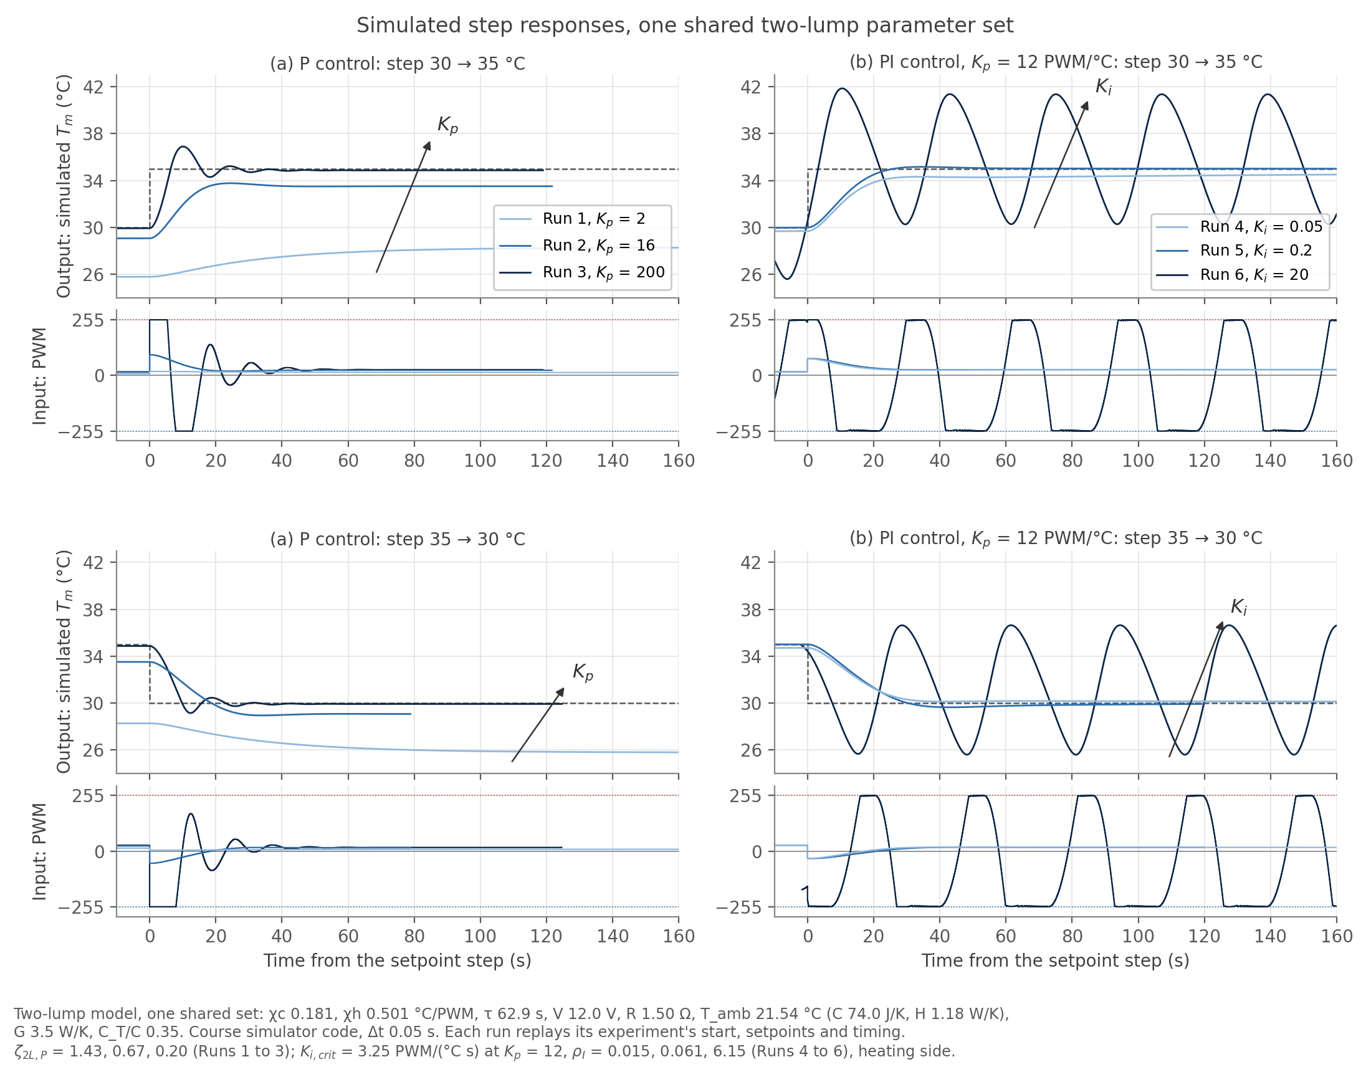
docs/figures/module_06/goldilocks_sim/overlay_p_and_pi_sim.png
