kapilnaidu1/phys39-naidu-cohen/docs/figures/module_06/goldilocks_sim/run6_sim.png

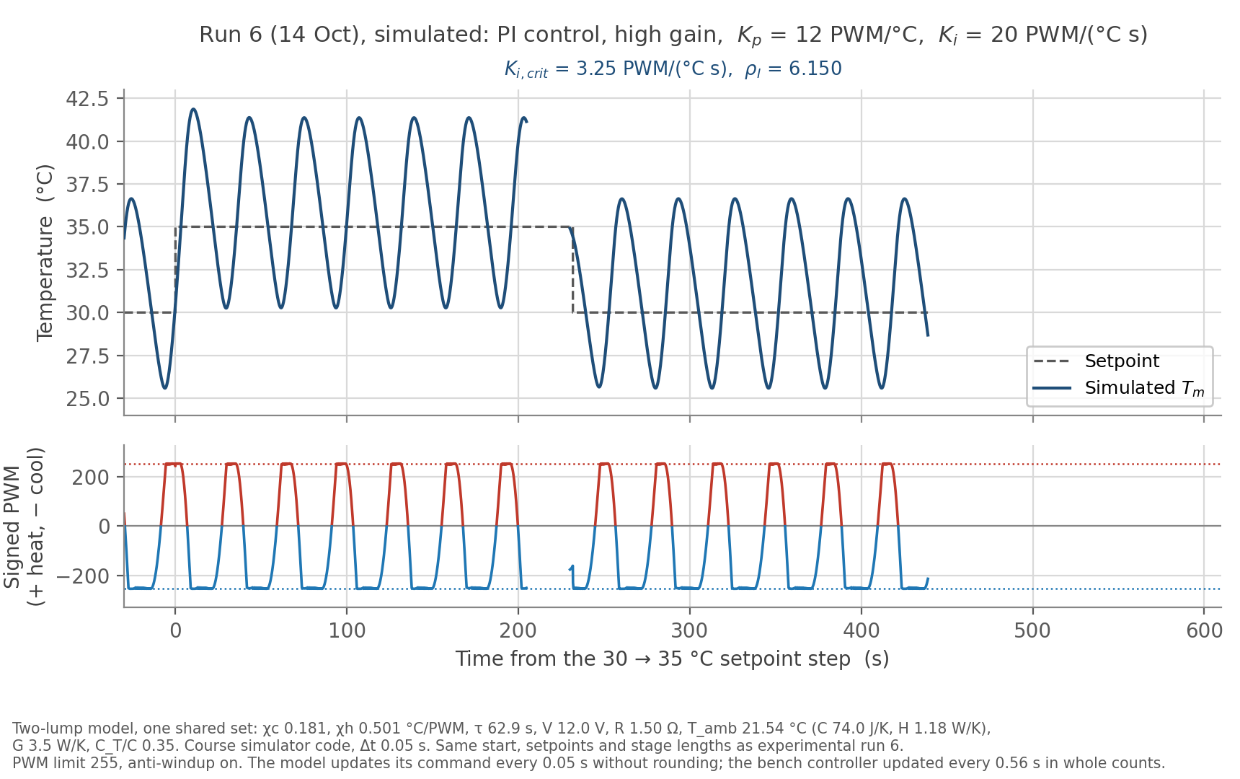
docs/figures/module_06/goldilocks_sim/run6_sim.png
