kapilnaidu1/phys39-naidu-cohen/docs/figures/module_06/open_loop_course_sim.png

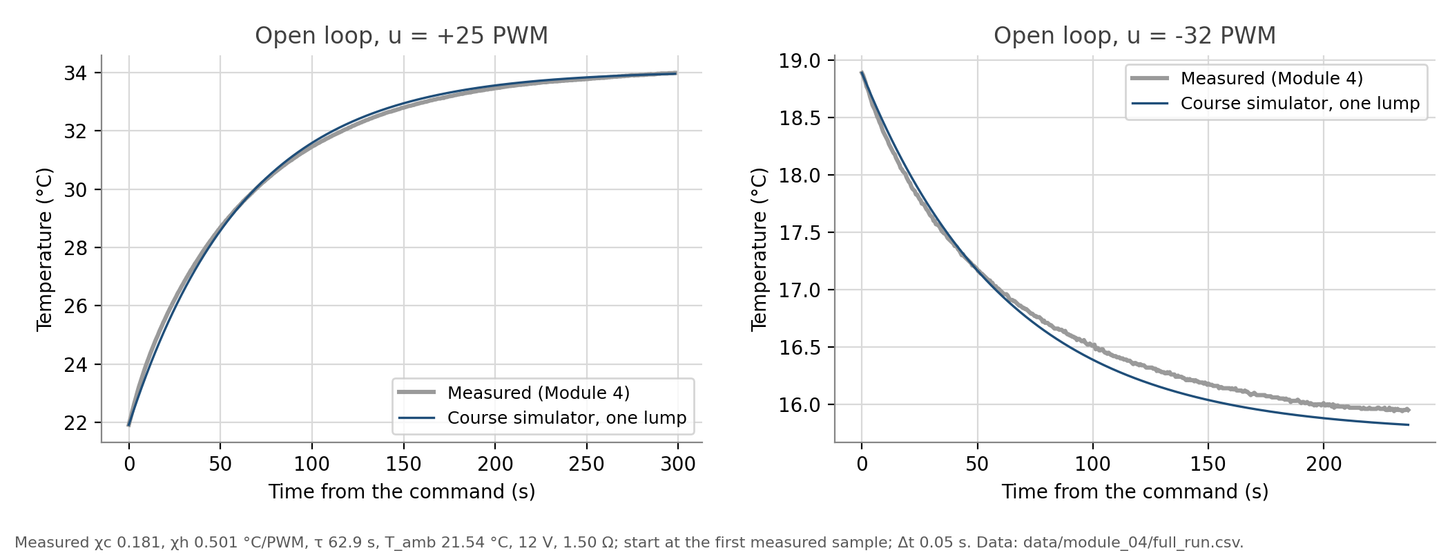
docs/figures/module_06/open_loop_course_sim.png
