kapilnaidu1/phys39-naidu-cohen/docs/figures/module_06/p_control_sim.png

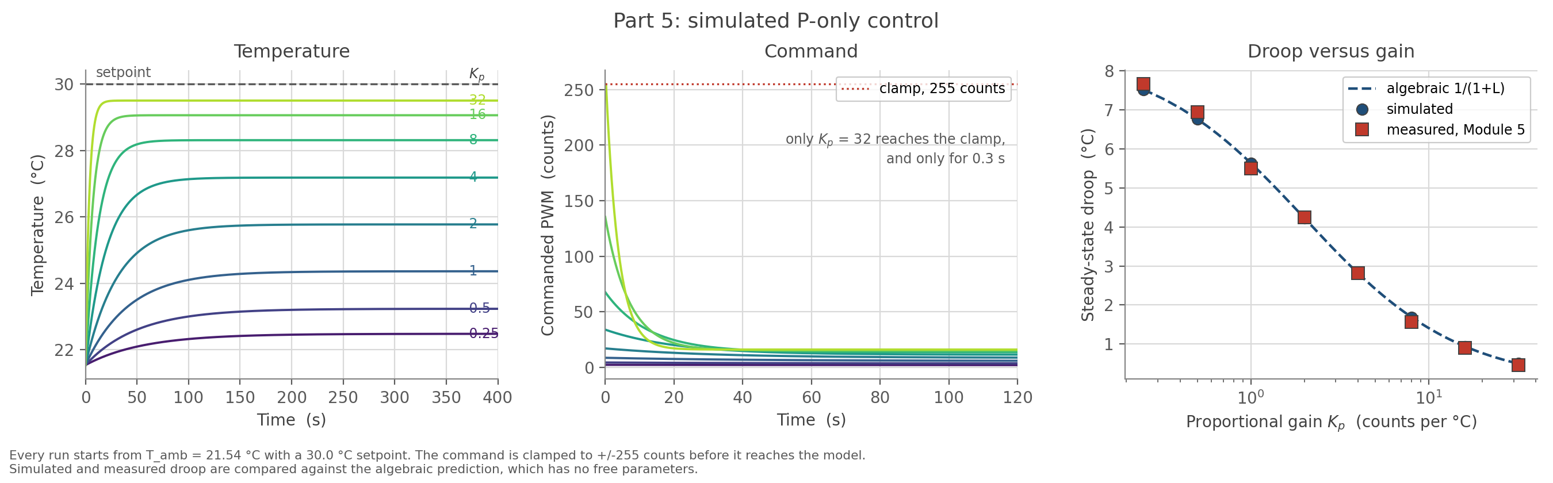
docs/figures/module_06/p_control_sim.png
