kapilnaidu1/phys39-naidu-cohen/docs/figures/module_06/pi_vs_p_sim.png

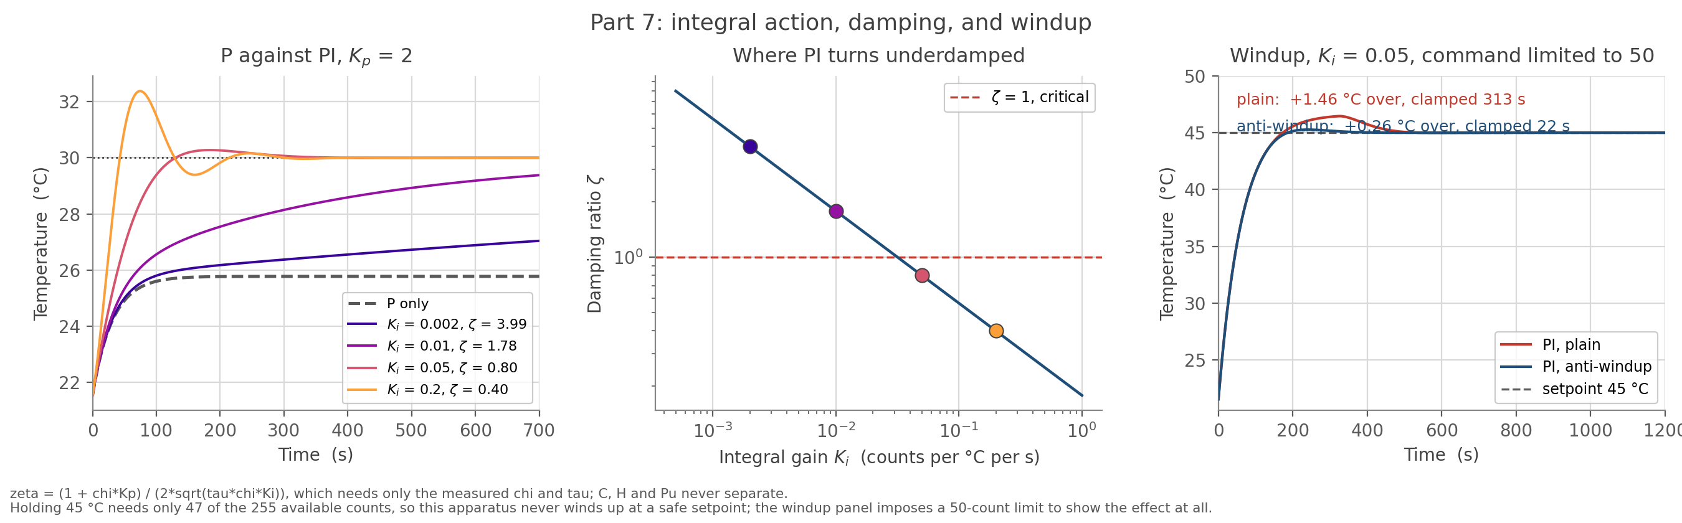
docs/figures/module_06/pi_vs_p_sim.png
