kapilnaidu1/phys39-naidu-cohen/docs/figures/module_06/tau_estimate.png

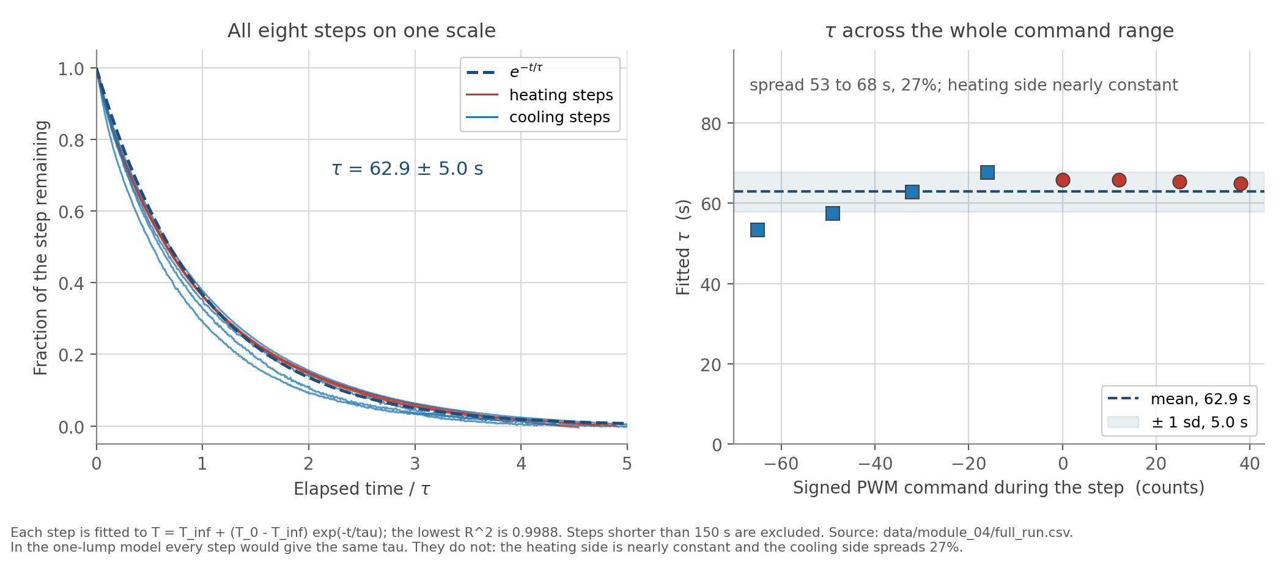
docs/figures/module_06/tau_estimate.png
