kapilnaidu1/phys39-naidu-cohen/docs/figures/module_07_sammy/sammy_rod_run_20261028_timeseries.png

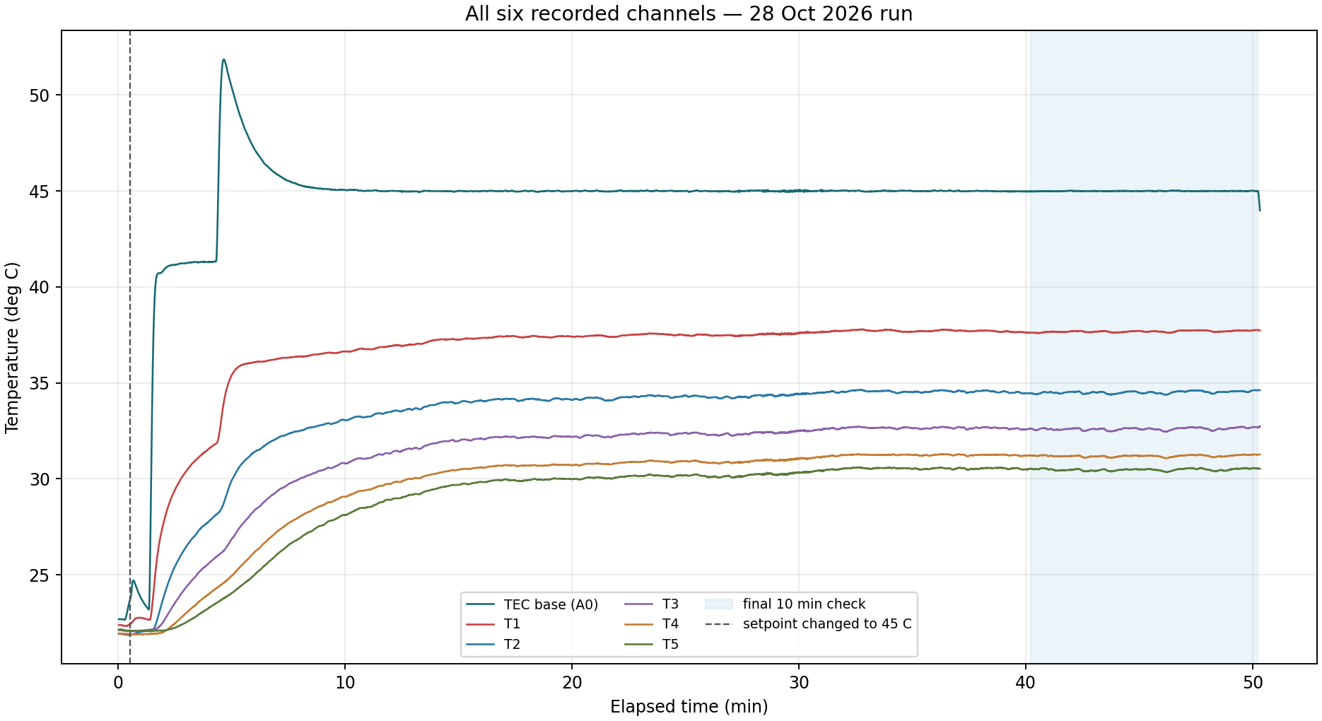
docs/figures/module_07_sammy/sammy_rod_run_20261028_timeseries.png
