kapilnaidu1/phys39-naidu-cohen/docs/figures/module_08/angstrom_mean_profile.png

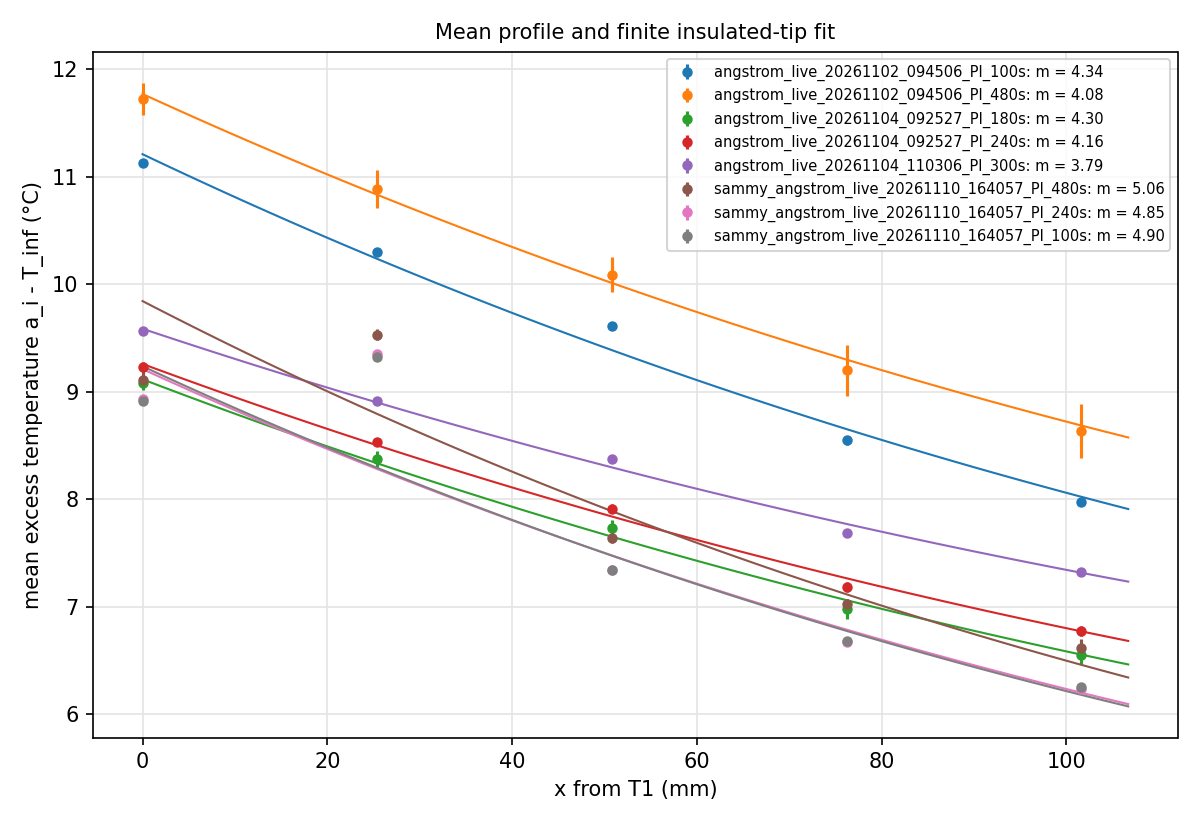
docs/figures/module_08/angstrom_mean_profile.png
