kapilnaidu1/phys39-naidu-cohen/docs/figures/module_08/model_compare_angstrom_live_20261104_092527_180s.png

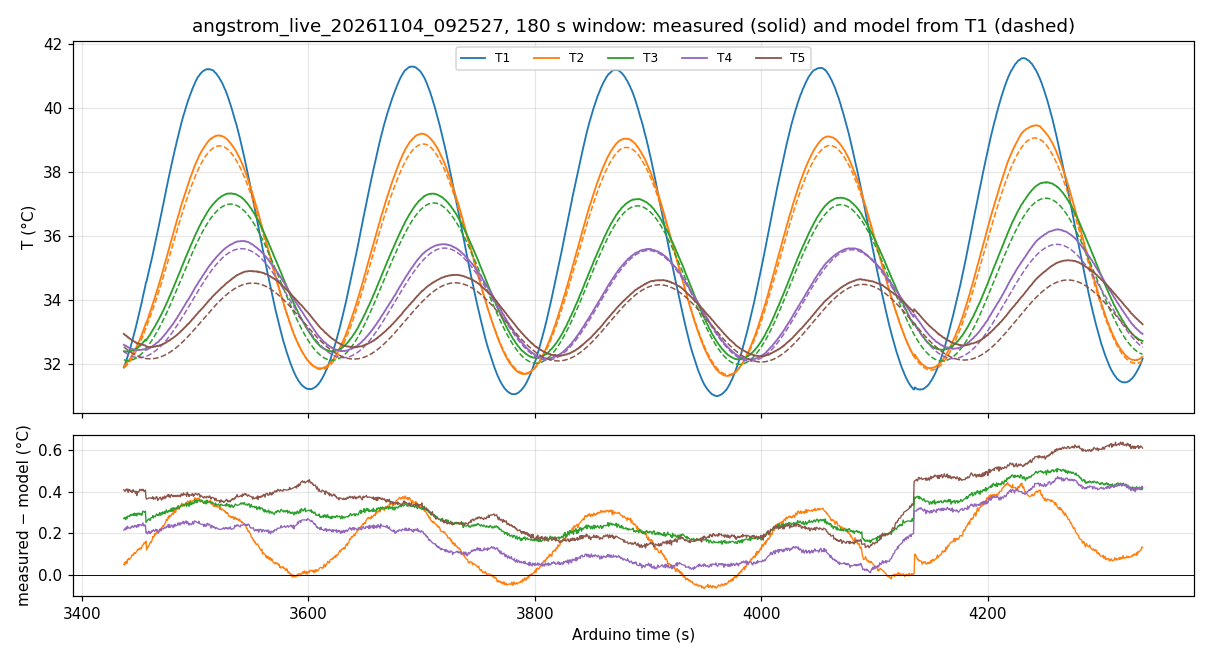
docs/figures/module_08/model_compare_angstrom_live_20261104_092527_180s.png
