kapilnaidu1/phys39-naidu-cohen/docs/figures/module_08/model_compare_sammy_angstrom_live_20261110_164057_240s.png

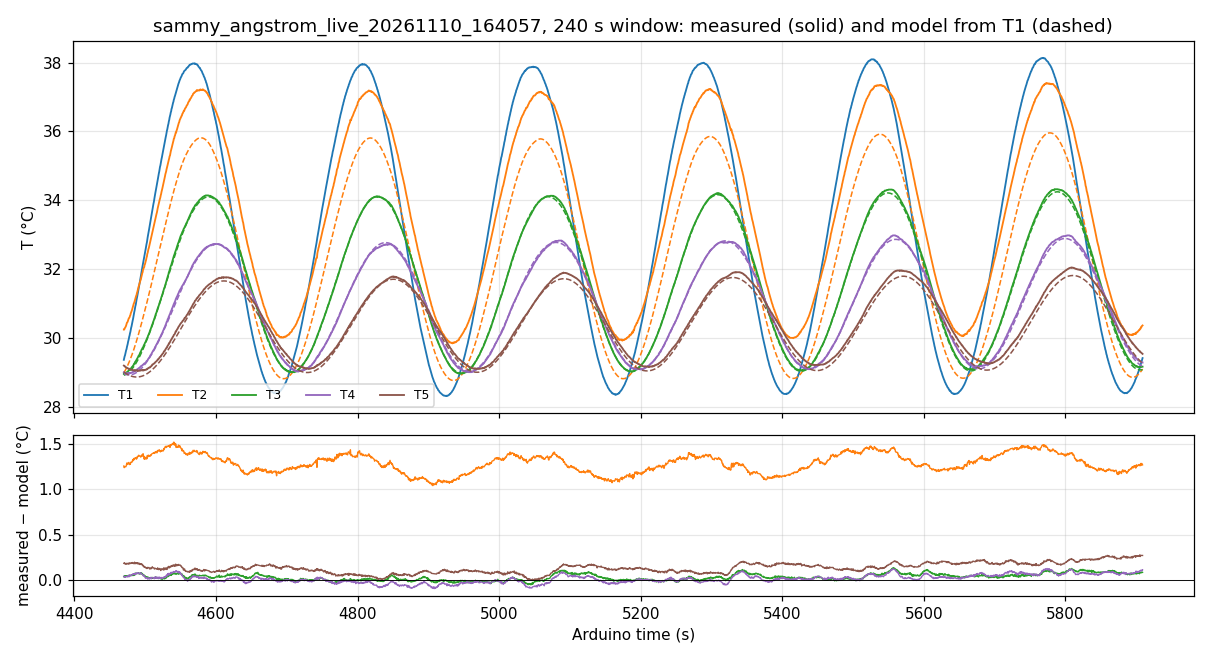
docs/figures/module_08/model_compare_sammy_angstrom_live_20261110_164057_240s.png
