kapilnaidu1/phys39-naidu-cohen/docs/figures/module_08_sammy/20261110_164057_kappa_vs_period.png

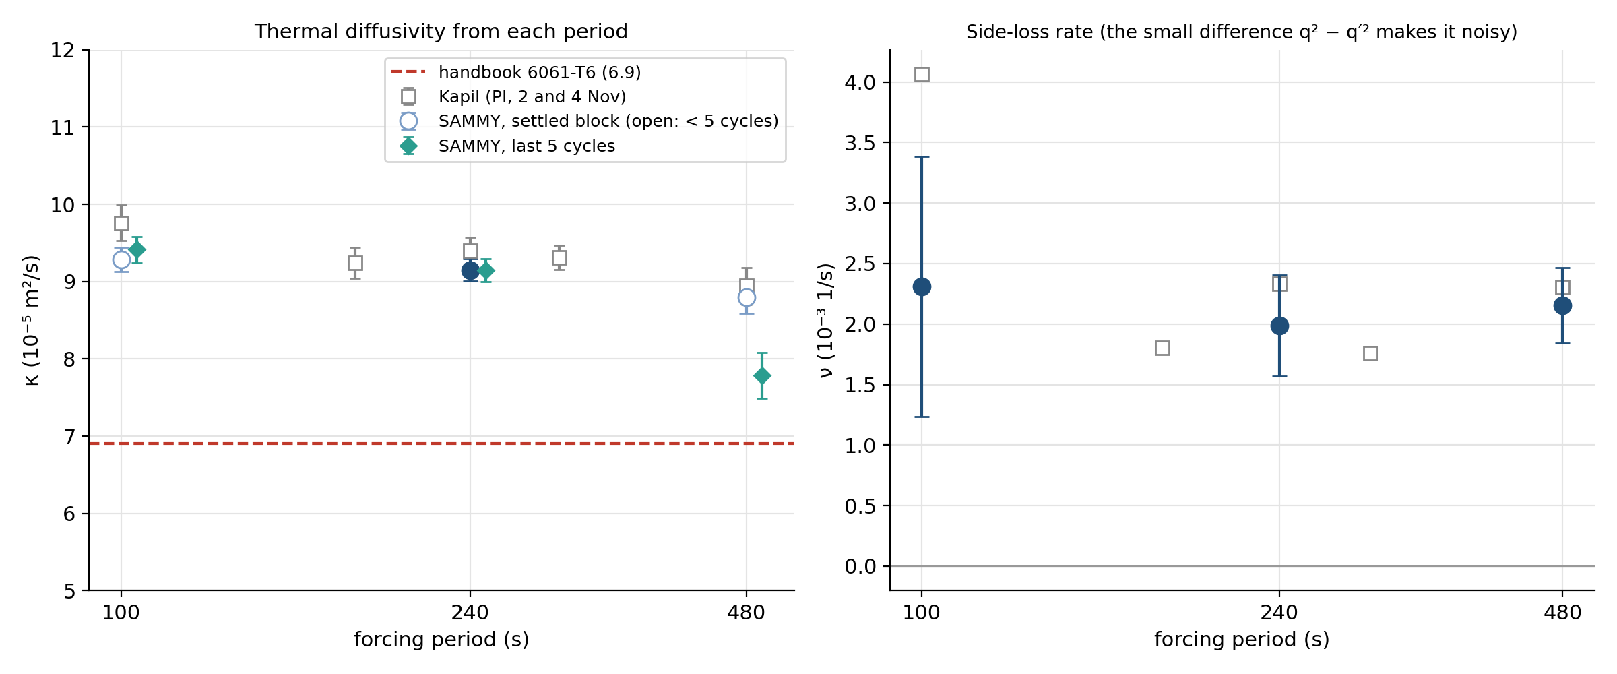
docs/figures/module_08_sammy/20261110_164057_kappa_vs_period.png
