kapilnaidu1/phys39-naidu-cohen/docs/figures/module_08_sammy/20261110_164057_settling.png

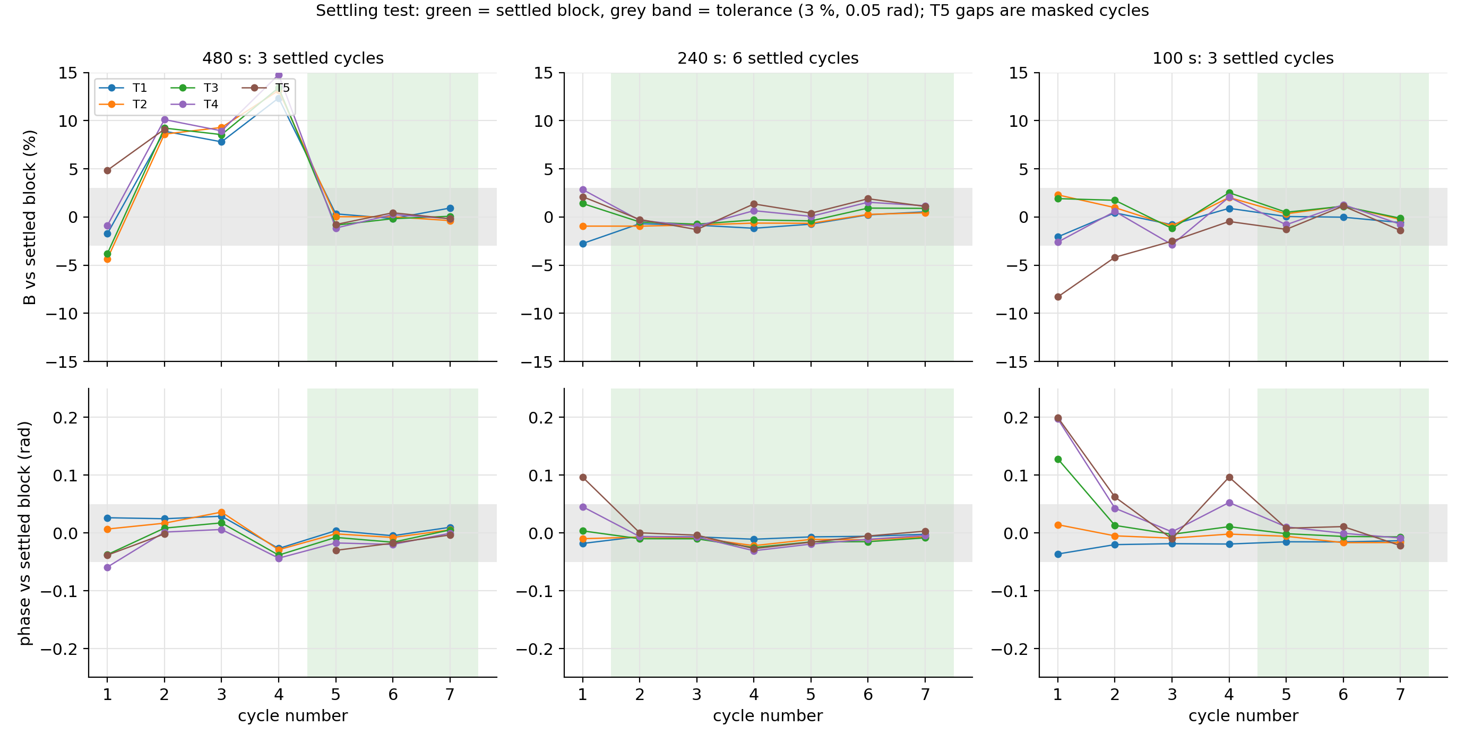
docs/figures/module_08_sammy/20261110_164057_settling.png
