kapilnaidu1/phys39-naidu-cohen/docs/figures/module_08_sammy/20261110_164057_spatial_fits.png

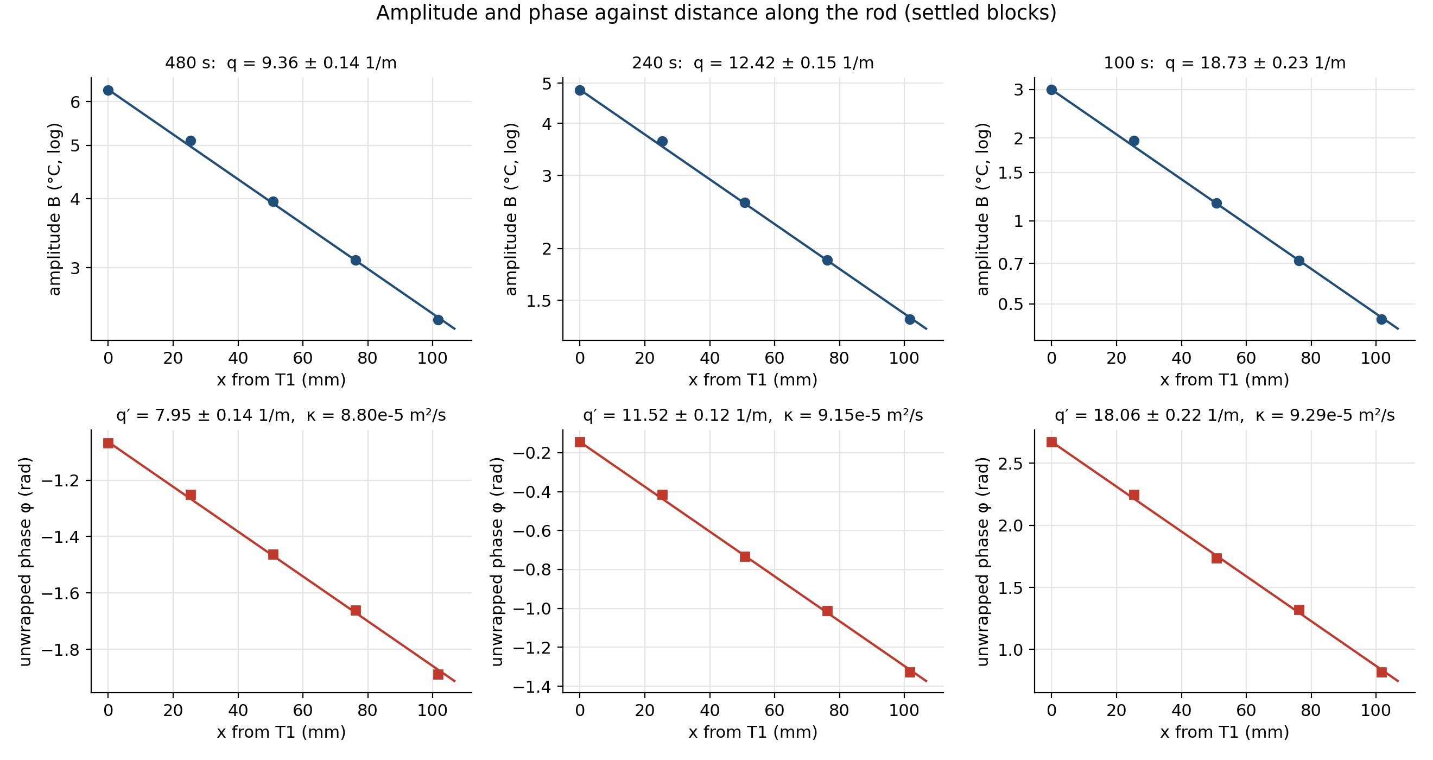
docs/figures/module_08_sammy/20261110_164057_spatial_fits.png
