kapilnaidu1/phys39-naidu-cohen/data/module_08/calibration_rod_run_20261026_105554.csv

channel | mean_C | sd_C | sem_C | offset_C | t0_s | t1_s | reference
base | 21.9804 | 0.0650 | 0.0388 | -0.0762 | 87.12 | 287.84 | mean of the rod channels
R1 | 22.3866 | 0.0480 | 0.0355 | 0.3300 | 87.12 | 287.84 | mean of the rod channels
R2 | 21.5972 | 0.0873 | 0.0647 | -0.4593 | 87.12 | 287.84 | mean of the rod channels
R3 | 22.5960 | 0.0206 | 0.0121 | 0.5395 | 87.12 | 287.84 | mean of the rod channels
R4 | 21.7221 | 0.0962 | 0.0712 | -0.3345 | 87.12 | 287.84 | mean of the rod channels
R5 | 21.9808 | 0.0843 | 0.0624 | -0.0758 | 87.12 | 287.84 | mean of the rod channels
