kapilnaidu1/phys39-naidu-cohen/data/module_08/calibration_rod_run_20261026_112627.csv

channel | mean_C | sd_C | sem_C | offset_C | t0_s | t1_s | reference
base | 22.5070 | 0.0472 | 0.0270 | 0.0605 | 150.00 | 390.00 | mean of the rod channels
R1 | 22.5030 | 0.0508 | 0.0251 | 0.0564 | 150.00 | 390.00 | mean of the rod channels
R2 | 22.2254 | 0.0539 | 0.0219 | -0.2211 | 150.00 | 390.00 | mean of the rod channels
R3 | 22.5121 | 0.0433 | 0.0191 | 0.0655 | 150.00 | 390.00 | mean of the rod channels
R4 | 22.4119 | 0.0441 | 0.0257 | -0.0347 | 150.00 | 390.00 | mean of the rod channels
R5 | 22.5804 | 0.0444 | 0.0203 | 0.1338 | 150.00 | 390.00 | mean of the rod channels
