kapilnaidu1/phys39-naidu-cohen/docs/figures/module_06/goldilocks/high_gain_steps.png

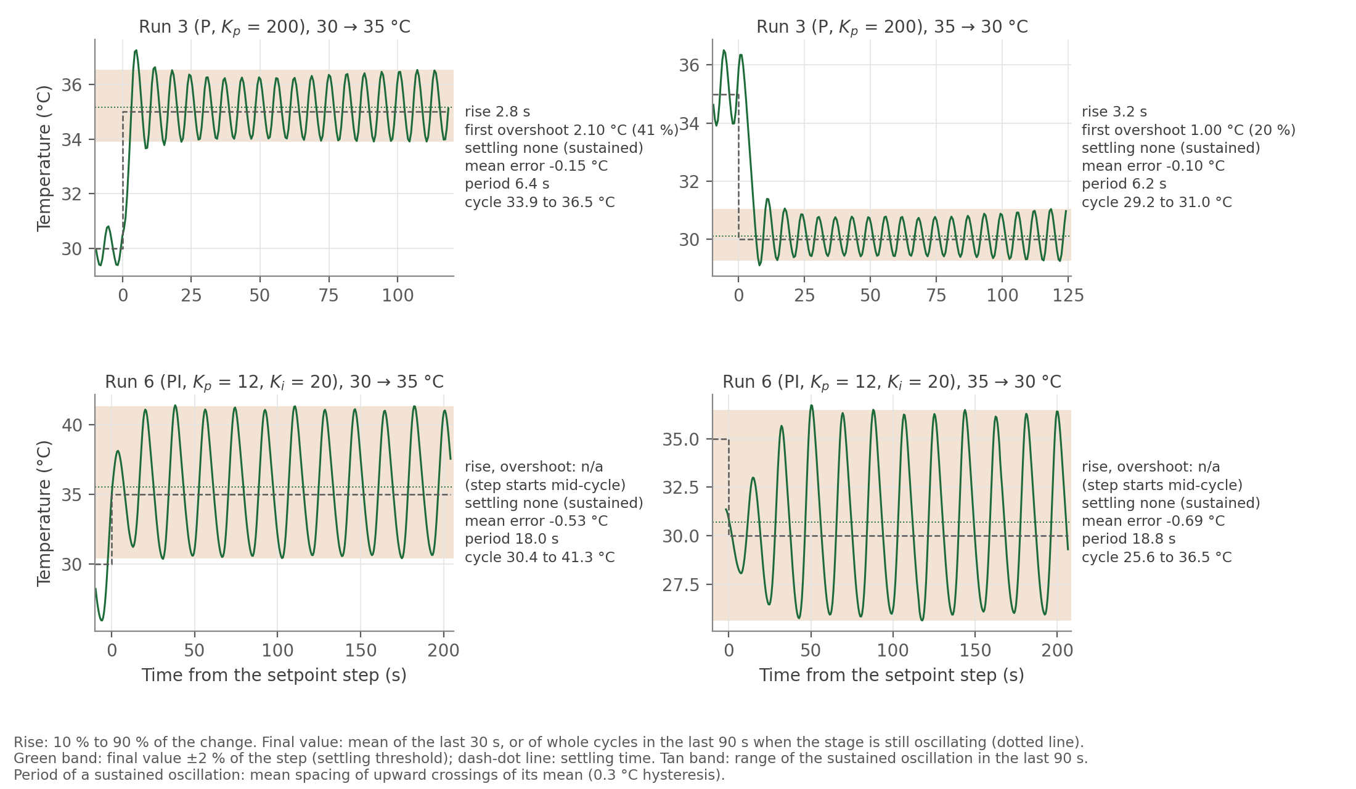
docs/figures/module_06/goldilocks/high_gain_steps.png
