kapilnaidu1/phys39-naidu-cohen/docs/figures/module_08/step_rod_run_20261028_092033_t0-600.png

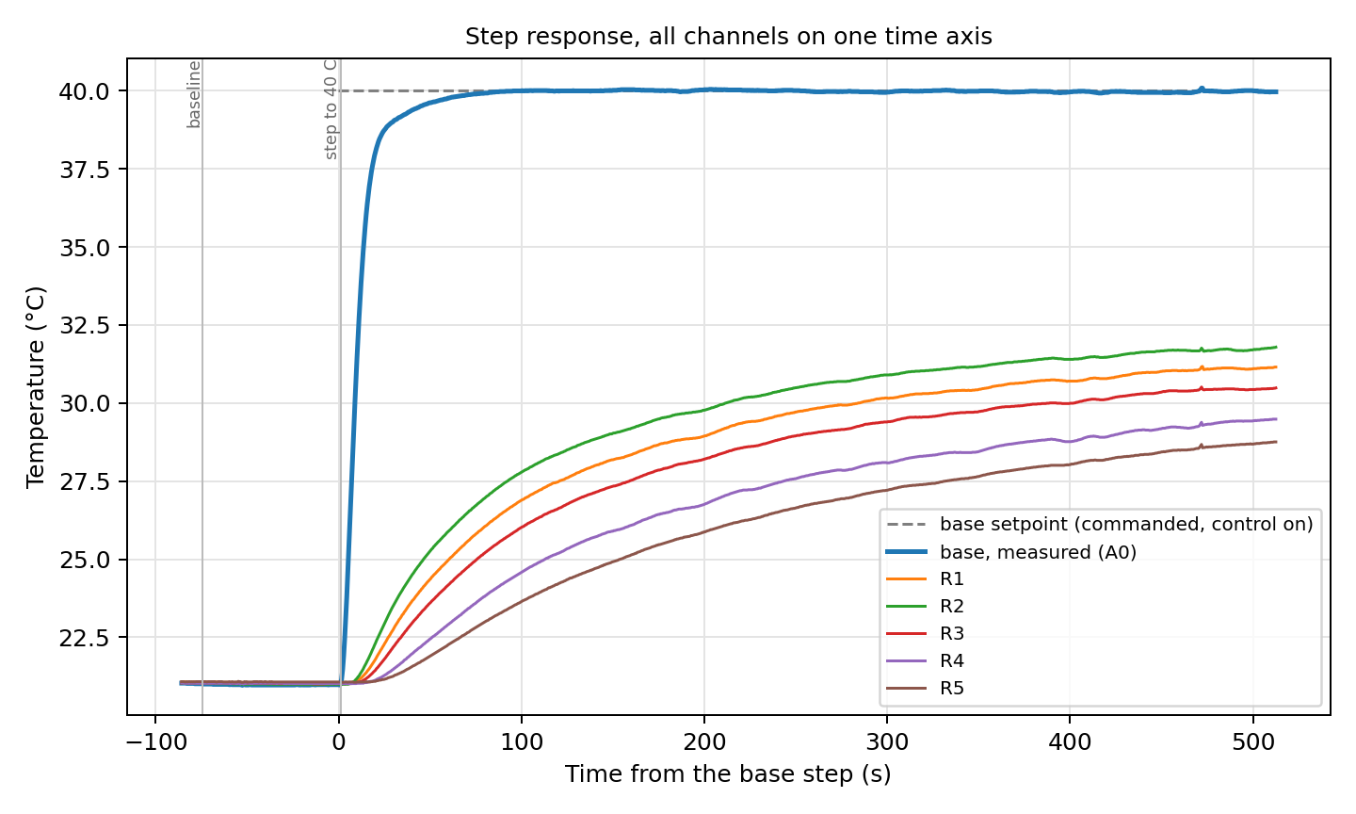
docs/figures/module_08/step_rod_run_20261028_092033_t0-600.png
