kapilnaidu1/phys39-naidu-cohen/data/module_05/sign_test_and_sweep.csv

time_s | temperature_C | pwm | heat_cool | setpoint_C | error_C | kp | p_enabled
0.92 | 20.72 | 0 | 1 | 30.00 | 9.28 | 0.250 | 0
1.44 | 20.73 | 0 | 1 | 30.00 | 9.27 | 0.250 | 0
1.95 | 20.74 | 0 | 1 | 30.00 | 9.26 | 0.250 | 0
2.46 | 20.75 | 0 | 1 | 30.00 | 9.25 | 0.250 | 0
2.97 | 20.76 | 0 | 1 | 30.00 | 9.24 | 0.250 | 0
3.47 | 20.77 | 0 | 1 | 30.00 | 9.23 | 0.250 | 0
3.98 | 20.78 | 0 | 1 | 30.00 | 9.22 | 0.250 | 0
4.49 | 20.79 | 0 | 1 | 30.00 | 9.21 | 0.250 | 0
5.00 | 20.79 | 0 | 1 | 30.00 | 9.21 | 0.250 | 0
5.51 | 20.80 | 0 | 1 | 30.00 | 9.20 | 0.250 | 0
6.02 | 20.80 | 0 | 1 | 30.00 | 9.20 | 0.250 | 0
6.53 | 20.81 | 0 | 1 | 30.00 | 9.19 | 0.250 | 0
7.03 | 20.82 | 0 | 1 | 30.00 | 9.18 | 0.250 | 0
7.54 | 20.83 | 0 | 1 | 30.00 | 9.17 | 0.250 | 0
8.05 | 20.83 | 0 | 1 | 30.00 | 9.17 | 0.250 | 0
8.56 | 20.84 | 0 | 1 | 30.00 | 9.16 | 0.250 | 0
9.07 | 20.84 | 0 | 1 | 30.00 | 9.16 | 0.250 | 0
9.58 | 20.85 | 0 | 1 | 30.00 | 9.15 | 0.250 | 0
10.09 | 20.85 | 0 | 1 | 30.00 | 9.15 | 0.250 | 0
10.59 | 20.86 | 0 | 1 | 30.00 | 9.14 | 0.250 | 0
11.10 | 20.87 | 0 | 1 | 30.00 | 9.13 | 0.250 | 0
11.61 | 20.88 | 0 | 1 | 30.00 | 9.12 | 0.250 | 0
12.12 | 20.88 | 0 | 1 | 30.00 | 9.12 | 0.250 | 0
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
