kapilnaidu1/phys39-naidu-cohen/docs/figures/module_06/open_loop_sim_vs_measured.png

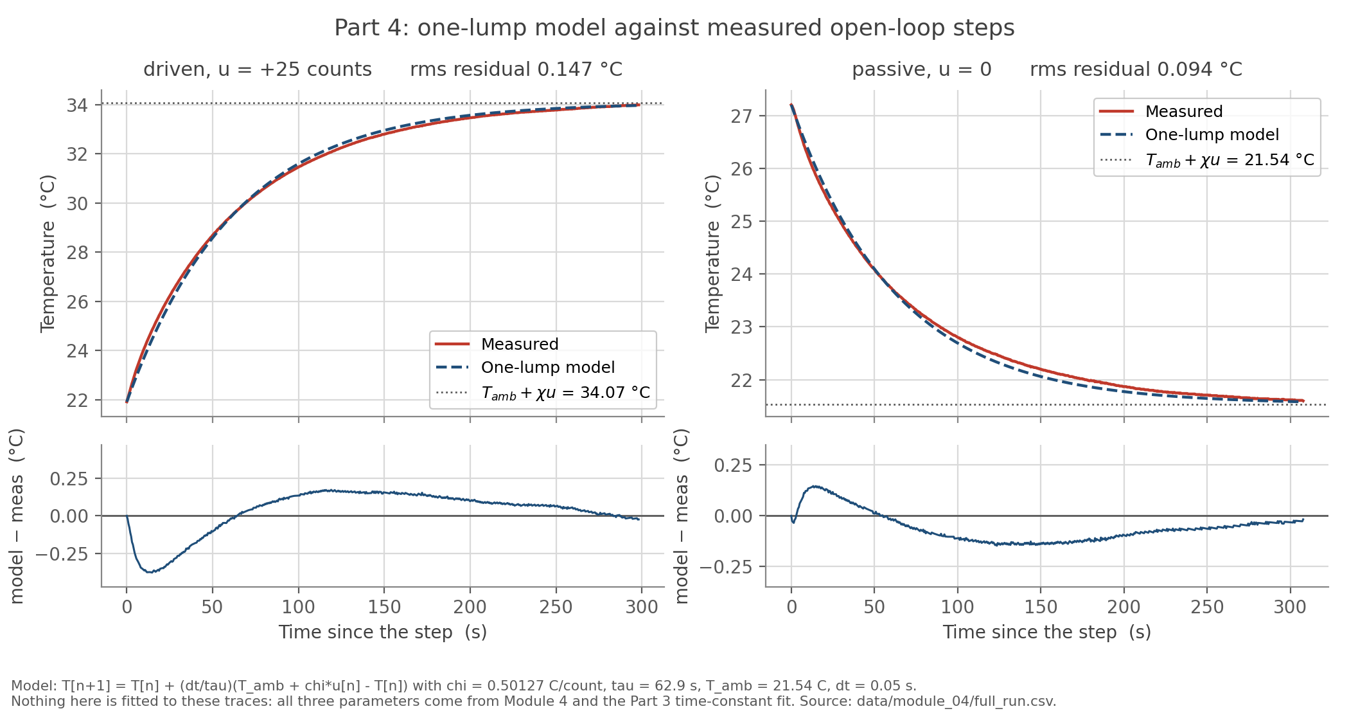
docs/figures/module_06/open_loop_sim_vs_measured.png
