kapilnaidu1/phys39-naidu-cohen/docs/figures/module_08/calibration_rod_run_20261026_105554.png

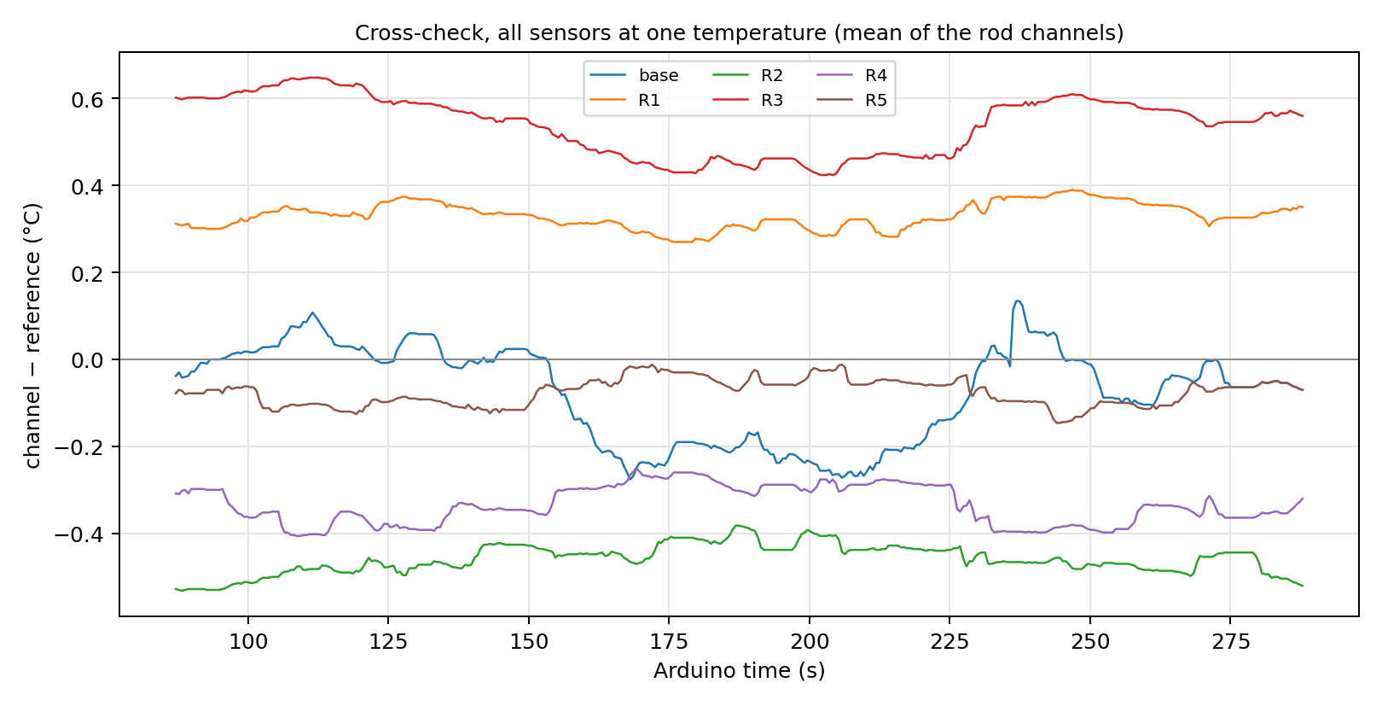
docs/figures/module_08/calibration_rod_run_20261026_105554.png
