kapilnaidu1/phys39-naidu-cohen/data/module_08/part2_parameters.txt

python3 python/analysis/part2_parameters.py --draws 2000 --seed 1

Module 8 Part II parameters: finite insulated-tip rod, Monte Carlo errors (2000 draws, seed 1)
D = 12.757 +/- 0.006 mm, R = 6.3785 mm, A/P = R/2 = 3.1892 mm; L = 281.9 +/- 1.3 mm; T2..T5 positions +/-1 mm
rho = 2700 kg/m3 (rel. err 0), c = 896 J/(kg K) (rel. err 0); literature k = 167 W/(m K)
stat = measurement scatter only (scaled by sqrt(chi2/dof) when > 1); tot = stat plus one common draw of positions, L, D (and rho, c) per iteration.

window        cyc     q (1/m)   q_p (1/m)   kappa 1e-5 stat/tot  nu 1e-3/s stat  k W/mK stat/tot  h W/m2K stat chi2/dof
2 Nov 100 s     5  18.60+/-0.39  17.54+/-0.72   9.63 0.45/0.48      3.69+/-2.93    233 11/12      28.4+/-22.6 586.8/6
2 Nov 480 s     5   9.09+/-0.24   7.75+/-0.17   9.30 0.32/0.37      2.10+/-0.45    225 8/9      16.2+/-3.5  35.9/6
4 Nov 180 s     5  13.97+/-0.38  13.52+/-0.39   9.24 0.37/0.39      1.14+/-1.40    224 9/10       8.8+/-10.8  75.7/6
4 Nov 240 s     5  12.44+/-0.20  11.37+/-0.28   9.25 0.28/0.32      2.36+/-0.75    224 7/8      18.2+/-5.8 113.1/6
4 Nov 300 s     6  11.05+/-0.20  10.22+/-0.25   9.27 0.29/0.33      1.62+/-0.62    224 7/8      12.5+/-4.8 258.3/6
10 Nov 480 s    3   9.29+/-0.16   7.94+/-0.29   8.88 0.34/0.41      2.08+/-0.57    215 8/10      16.0+/-4.4  89.8/6
10 Nov 240 s    6  12.53+/-0.24  11.58+/-0.19   9.01 0.22/0.27      2.06+/-0.68    218 5/6      15.9+/-5.2 185.7/6
10 Nov 100 s    3  18.72+/-0.39  18.21+/-0.24   9.22 0.23/0.31      1.77+/-1.52    223 6/7      13.6+/-11.8 332.7/6
11 Nov 480 s    6   9.25+/-0.34   7.91+/-0.22   8.94 0.42/0.45      2.06+/-0.61    216 10/11      15.9+/-4.7 144.2/6

(kappa with the 1 mm position error added in quadrature instead, as in angstrom_finite_fit.py: 9.74, 9.40, 9.19, 9.36, 9.33, 9.22, 9.10, 9.28, 9.27)

Weighted means over all nine windows (weights from stat errors):
  kappa             9.172  stat 0.100  total 0.181 1e-5 m2/s  chi2 3.1/8
  nu                2.020  stat 0.234  total 0.246 1e-3 1/s   chi2 1.4/8
  k               221.885  stat 2.410  total 4.381 W/(m K)    chi2 3.1/8
  h                15.583  stat 1.804  total 1.900 W/(m2 K)   chi2 1.4/8
  nu_over_kappa    22.113  stat 2.555  total 2.742 1/m2       chi2 1.5/8

Weighted means over the six windows with >= 5 settled cycles (weights from stat errors):
  kappa             9.195  stat 0.117  total 0.188 1e-5 m2/s  chi2 2.2/6
  nu                2.015  stat 0.261  total 0.272 1e-3 1/s   chi2 1.4/6
  k               222.455  stat 2.832  total 4.539 W/(m K)    chi2 2.2/6
  h                15.548  stat 2.011  total 2.102 W/(m2 K)   chi2 1.4/6
  nu_over_kappa    21.891  stat 2.882  total 3.046 1/m2       chi2 1.4/6

By period (weighted over days, stat errors):
    100 s: kappa 9.30 +/- 0.20, k 225 +/- 5, h 16.8 +/- 10.4
    180 s: kappa 9.24 +/- 0.37, k 224 +/- 9, h 8.8 +/- 10.8
    240 s: kappa 9.11 +/- 0.17, k 220 +/- 4, h 17.0 +/- 3.9
    300 s: kappa 9.27 +/- 0.29, k 224 +/- 7, h 12.5 +/- 4.8
    480 s: kappa 9.06 +/- 0.20, k 219 +/- 5, h 16.1 +/- 2.4

k against literature 167 W/(m K) (range 166 to 172 over 0 to 100 C): ratio 1.329 (+33 %), 11 total sigma above the top of the range
m from nu/kappa: 4.70 +/- 0.29 1/m (m^2 = 22.1 +/- 2.7 1/m2, total); Module 7 stationary fin m = 4.117 +/- 0.07 (m^2 = 16.9 +/- 0.6)
mL = 1.326 +/- 0.082;  transverse Biot Bi = (nu/kappa) R^2 / 4 = 2.25e-04
Finite-length effect at T5 (x = 101.6 mm): |cosh(s(L-x))/cosh(sL) - exp(-sx)| / |cosh(s(L-x))/cosh(sL)|
    100 s: 0.12 %
    180 s: 0.68 %
    240 s: 1.19 %
    300 s: 2.00 %
    480 s: 3.97 %
  mean profile with m = 4.70: 9.5 %

Natural-convection scale (air properties at 300 K, Incropera Table A.4):
  measured h = 15.6 +/- 1.9 W/(m2 K) (total)
  dT =  5.0 K: horizontal cylinder (Churchill-Chu, Ra_D = 949) h = 5.3; vertical plate of height L (Churchill-Chu, Ra_L = 1.02e+07) h = 2.9 (D/L below 35/Gr^0.25: plate formula not valid, curvature raises h)
  dT = 10.0 K: horizontal cylinder (Churchill-Chu, Ra_D = 1899) h = 6.2; vertical plate of height L (Churchill-Chu, Ra_L = 2.05e+07) h = 3.6 (D/L below 35/Gr^0.25: plate formula not valid, curvature raises h)
  dT = 15.0 K: horizontal cylinder (Churchill-Chu, Ra_D = 2848) h = 6.7; vertical plate of height L (Churchill-Chu, Ra_L = 3.07e+07) h = 4.0 (D/L below 35/Gr^0.25: plate formula not valid, curvature raises h)
  For h proportional to dT^(1/4), the small-signal coefficient seen by the oscillation is d(h dT)/d(dT) = 1.25 h.
  Linearised radiation 4 eps sigma T^3 at 300 K = 6.1 eps W/(m2 K) (emissivity of this rod not measured).
