kapilnaidu1/phys39-naidu-cohen/(commit log)

2026-09-07 Module 1: sketches, averaging data and evidence note
    Adds the five Module 1 sketches, the raw Serial Monitor capture from Parts 3C and 3D, and the A1 evidence note. Measured s1000/s1 = 0.0357 against a prediction of 0.0316, 112.0 us per analogRead conversion, and 490.42 Hz PWM on pin 9.
2026-09-07 Track the docs/images folder ahead of adding Module 1 figures
2026-09-07 Correct series resistor to 3.25k and note that Blink required no recorded data
    [blink_ratio.ino, pwm_brightness.ino]
2026-09-07 Add Part 3C/3D raw data and finish evidence note
    Raw Serial Monitor capture at the ADC 863/864 boundary, plus the code-512 quantization observation. Evidence note updated with the thermal cutout identification, corrected Figure 7 caption, and the 3.238 us rise-time measurement.Raw Serial Monitor capture at the ADC 863/864 boundary, plus the code-512 quantization observation. Evidence note updated with the thermal cutout identification, corrected Figure 7 caption, and the 3.238 us rise-time measurement.
2026-09-07 Add all ten figures and correct captions and PWM table to match them
    Figures 1-10 are now in docs/images/. Every caption rewritten to describe
    what its own image actually shows, and the Part 4 table re-read directly
    off Figures 8 and 9 so the numbers and the captures agree.
2026-09-09 Module 2: pre-class answers and Part 1/2 thermistor sketch
2026-09-09 Module 2 Part 3A: trim-pot PWM and H-bridge direction sketch
2026-09-14 Add Module 2 Part 3 motor drive records and sync maxDuty to the value used
    maxDuty was still 80 in the repository copy, the cap used while checking
    the H-bridge inputs on the scope with no load. Part 3C ran at 255 with
    the instructor present and the TEC unplugged, so the sketch now carries
    the value that actually produced the data.
    The new data file records the computed PWM timebase (490.196 Hz, 2040 us,
    8.000 us per analogWrite count), the direction symmetry test at four fixed
    knob settings, the speed sweep plateaus with predicted pulse widths, the
    double quantization in the ADC-to-PWM chain, and an honest account of what
    the BK 2120B analog traces support.
    [trimpot_hbridge.ino]
2026-09-14 Add C2 evidence note, Module 2 Parts 1-2 data, and the two Module 3 manual TEC sketches
    C2 note covers all nine required items. Item 8, the M+/M- comparison in both
    directions, is written up with the probe-grounding and load conditions but is
    flagged OPEN: our Part 3B/3C captures were of the Arduino control pins 9 and
    10, not the H-bridge power outputs. Marked rather than filled in, since the
    TEC replaces the motor at the start of Module 3.
    Module 3 Parts 2 and 3 sketches added. Both start disarmed and force PWM to
    zero until the trim pot has been seen at zero, so the pre-power checklist line
    is true rather than hopeful, and both cap duty at 64 of 255 for the first TEC
    run. The hardware-dir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
    [tec_manual_fixed_direction.ino, tec_manual_hardware_direction.ino]
2026-09-14 Add Module 3 Part 6 sketch and both Python programs, plus raw-chain diagnostics
    tec_python_control accepts SET PWM n DIR HEAT|COOL, clamps to 0-255, starts
    at PWM 0, and forces PWM to 0 on any malformed command. The parser rejects
    partly-numeric values rather than letting atoi turn them into a silent zero.
    Python: display-only strip chart for Part 4 and the full manual control GUI
    for Part 5. Both print every received line to the terminal, log CSV with
    units in the column names, and tolerate extra bracketed diagnostics after
    the four parsed fields.
    Both manual sketches now also print average ADC, divider voltage and
    thermistor resistance in brackets. Without those you cannot tell an
    implau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
2026-09-14 Parameterize the thermistor profile and record the plate sensor identification
    The TEC plate thermistor is not the 100 kOhm part from Module 2. With the
    TEC unpowered the divider sat at ADC 80.0, 0.391 V, so the lower leg was
    8.48 kOhm, steady to one ADC count. A 100 kOhm NTC reaches that only near
    83 C and the plate was at room temperature, so the sensor is a 10 kOhm part
    reading about 29 C.
    All three Module 3 sketches now select Rnominal and Beta from one
    SENSOR_IS_10K switch, print the active sensor profile at startup so every
    log states its own calibration, and document that Rfixed is physical.
    The upper leg is still 100 kOhm, which leaves the divider at ADC 80 where
    one count is 0.361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
2026-09-14 Correct the sensor diagnosis: two wirings fit the measurement, not one
    The earlier commit concluded the plate sensor is a 10 kOhm part. That was
    premature. ADC 80 at 0.391 V is equally consistent with the Module 2 100
    kOhm thermistor wired as the UPPER leg over a 10 kOhm lower leg, in which
    case A0 reads across the resistor rather than across the sensor and the
    thermistor is at 21.8 C, which is simply room temperature.
    One measurement read through an assumed model cannot test that model. The
    sketches now default to the part we can identify rather than asserting one
    we cannot, and carry the pinch test that separates the two cases by the sign
    of the ADC response. Warming an NTC lowers its res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
    [tec_manual_fixed_direction.ino, tec_manual_hardware_direction.ino, tec_python_control.ino]
2026-09-14 Resolve the 83 C reading: the thermistor was never connected
    A0 was floating. The steady ADC 80.0 was an unconnected analog input, not a
    measurement, and both earlier diagnoses were arithmetic performed on it.
    Restored the 100 kOhm profile and Rfixed = 100000.0, and replaced the
    two-hypothesis comment block with the expected room-temperature values and
    the orientation check that would have caught this in ten seconds.
    Recorded in data/module_03 because the failure is the same one that cost us
    time in Module 2, where three physical explanations were proposed for what
    turned out to be a loose lead. Reasoning about the model before verifying
    the connection, twice. The averaging made it worse r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
    [tec_manual_fixed_direction.ino, tec_manual_hardware_direction.ino, tec_python_control.ino]
2026-09-14 Refuse to report a temperature when the divider is not present
    All three Module 3 sketches now gate the temperature field on a plausibility
    window, ADC 20 to 1000, which with 100 kOhm against 100 kOhm spans about
    +118 C to -40 C. Anything outside it is a wiring fault, not a temperature,
    and the sketch prints --- plus the likely cause instead of a number.
    This is the guard that would have caught both of this week's failures. A
    floating A0 read a steady 80 and was converted into a confident 83 C, and a
    sensor wired to A1 instead of A0 leaves A0 with no upper resistor and pins
    it near 0 V, which the old code would also have turned into a number.
    An instrument that cannot measure should say so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
    [tec_manual_fixed_direction.ino, tec_manual_hardware_direction.ino, tec_python_control.ino]
2026-09-16 Rewrite the README for the C2 checkpoint and drop the Module 3 debug note
    The README still described Module 1 only. The C2 rubric gives a point for
    current code and documentation, and the Git checkpoint criteria ask that
    another person can follow the README from a fresh checkout without guessing
    which of several similarly named files is authoritative.
    It now carries the full pin map, the oscilloscope grounding rule, which
    sketch pairs with which Python program, how to upload and run both, both
    serial line formats with a field-by-field meaning, the CSV columns, and the
    Module 1 and Module 2 result tables. All 17 referenced paths resolve.
    Removed data/module_03/sensor_identification_14sep.tx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
2026-09-16 Group Arduino sketches by module
    arduino/module_02/ and arduino/module_03/ instead of flat sketch folders,
    so the layout matches code/module_01/. Paths updated in the README, the C2
    note and the Python headers.
2026-09-16 Remove em dashes, en dashes and Unicode minus signs from all notes
    Replaced with commas, hyphens and ASCII minus. M- is now written the way the
    board is labelled.
2026-09-16 Start the Module 3 note with the pre-power checklist
    Fills the checklist rows the repository already answers and marks the
    rest as pending a bench reading.
2026-09-16 Fill three checklist rows from the bench photographs
    Board is an Elegoo UNO R3, the ALT-1210T has no adjustable current
    limit, and the heat exchanger is a liquid loop rather than air.
2026-09-16 Add a staged build order with a test gate after each stage
    Each stage is verified before the next is added, so a fault can only
    be in the part just built.
2026-09-16 Record gate 3 pass and the confirmed sensor identity
    112.68 kOhm at 22.68 C matches the datasheet curve, so the 100 kOhm
    profile in the sketches is correct. Port recorded.
2026-09-16 Require the pot to be held at zero before arming the output
    A single-sample arm test is satisfied by one dropout from an
    intermittent pot connection, which arms the sketch with the knob still
    turned up.
2026-09-16 Log trim pot readings that jump faster than a hand can turn
    Diagnostic only. A sustained dropout cannot be filtered out, so this
    records the fault rather than hiding it.
2026-09-16 Port the pot arm hold and jump detector into the Part 3 sketch
2026-09-16 Print pot ADC in the Part 3 diagnostic
2026-09-16 Reject temperature steps faster than the sensor can physically make
    The ADC window guard passes contact artefacts that land inside it. The
    sensor's measured time constant is 15.1 s, so a 5 C step in one 500 ms
    report is a connection, not a temperature.
2026-09-16 Add a demo data source so Parts 4 and 5 can be built off the bench
    Also print only the four extracted values in the terminal, as Part 4
    requires, instead of echoing the raw Arduino line.
2026-09-16 Module 3 Part 3: direction calibration measured, PIN9_IS_HEAT = false
    Both directions driven at duty 40 with the 12 V supply on:
    pin 11 = 0 V -> PWM on pin 10 -> plate rose at +0.209 C/s -> HEAT
    pin 11 = 5 V -> PWM on pin 9 -> plate fell at -0.118 C/s -> COOL
    The cooling figure was taken at 24.4 C, 1.4 C above ambient, where passive
    decay contributes 0.009 C/s, so the plate was falling about 12x faster than
    it can unaided. Opposite signs in the two switch positions also rule out the
    thermistor sitting on the wrong face of the Peltier.
    Sets the constant in tec_manual_hardware_direction and tec_python_control,
    adds the raw excerpts under data/module_03/, and records the runs and the
    r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
    [tec_manual_hardware_direction.ino, tec_python_control.ino]
2026-09-16 Module 3 Part 6: cap output at duty 64 for first power-on, announce the cap
    maxDuty becomes an output ceiling distinct from the 0-255 command range the
    assignment specifies. Commands above it are still accepted and parsed, but
    driven at the ceiling. Duty 63 measured +25.7 C/min on this plate, so 255
    would pass 80 C from room temperature in under a minute.
    The cap is never silent: setup() announces it and any acknowledgement above
    the ceiling says the command was capped, so the GUI cannot report 200 while
    the plate behaves like 64.
    [tec_run.csv]
2026-09-23 Part 4: resolve the serial port instead of hard-coding one name
    macOS renames the Arduino's device node when it is plugged into a different
    physical USB socket, so a hard-coded /dev/cu.usbmodem1101 turns a moved cable
    into an Errno 2 that reads like a missing program. SERIAL_PORT becomes a
    preference: used if present, otherwise the single attached USB serial device
    is used and the substitution is printed. Two candidates or none exits with
    the port list rather than guessing.
    Resolution moved ahead of window construction, since the window opens the CSV
    in its constructor and exiting after that left a header-only file that looked
    like a run recording no data rather than one that never started.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
    [tec_temperature_strip_chart.py]
2026-09-23 Part 4: drop late serial lines during shutdown, keep the baseline run
    Qt delivers queued line_received signals after closeEvent returns, so on_line
    was called after csv_file.close() and raised ValueError: I/O operation on
    closed file. The traceback printed after the clean shutdown message, which
    reads like a failed run even though every row had already been flushed. A
    _closing flag set at the top of closeEvent drops those late lines.
    Also keeps the 23 Sept baseline run as part4_baseline_21C_nodrive.csv. 391
    rows, 195 s, 0.50 s cadence throughout, ambient 20.97 C. It demonstrates the
    Part 4 program end to end but carries no drive: PWM is 0 for every row
    because the trim pot never read low en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
    [part4_baseline_21C_nodrive.csv]
2026-09-23 Add bench_check_inputs: minimal A0 and A1 contact test
    Diagnostic sketch, not an assignment deliverable. Reads only the two analog
    inputs and prints raw counts with min, max and span held since reset. No PWM,
    no arming, no direction logic, no conversion, so a channel fault has nowhere
    to hide behind another subsystem.
    Holds both bridge inputs LOW for the life of the sketch, so the TEC cannot be
    driven while the board is being handled.
    Min and max are held rather than showing only the live value because an
    intermittent contact glitches for one sample and recovers, which is
    unwatchable in a scrolling number but obvious in a retained extreme.
    [bench_check_inputs.ino]
2026-09-23 Part 3: cooling confirmed below ambient, and the 35 s onset delay
    Duty 28 on pin 9 drove the plate from 21.47 C ambient to 18.62 C and still
    falling, 2.85 C below ambient. No passive process moves a plate away from
    room temperature, so pin 9 is the cooling direction and PIN9_IS_HEAT = false
    is confirmed from a second independent run.
    This also resolves the contradiction recorded on 16 September. Drive was
    commanded at t=90 and the temperature did not move until t=125: a 35 second
    onset delay. Several earlier runs were 3 to 7 s long, including one read as
    evidence that 12 V was not reaching the bridge. The supply was on; the
    intervals were far shorter than the plate's response time. Future r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
    [tec_run.csv]
2026-09-23 Part 5: drop late serial lines during shutdown
    Same race the strip chart had. Flag is set after the zero-PWM stop command
    goes out, so the actuator is still commanded off, but before the CSV closes,
    so queued lines delivered after closeEvent are discarded instead of raising
    on a closed file.
    [tec_run.csv]
2026-09-23 Parts 5 to 7: heat/cool cycle recorded, inverted direction label explained
    23 C swing about a 21.5 C ambient, 12 C below and 11 C above, both legs
    clear of ambient so both are the Peltier working rather than passive drift.
    The run's direction labels are inverted because the board carried an older
    tec_python_control with PIN9_IS_HEAT = true, so HEAT selected pin 9, which
    three independent runs now show is the cooling direction. Recorded rather
    than re-run, with the reasoning: every component behaved correctly and the
    one wrong boolean inverted the button, the printed word and the CSV column
    together, which is the case no internal consistency check can catch.
    Also records the 3.7x heating/co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
    [tec_control_run.csv]
2026-09-23 Raise output ceiling to full scale, widen the GUI axis, surface the cap
    maxDuty was 64. The GUI commanded 255 and the bridge received 64, so the
    plate reached only +27 C and -10 C from ambient and the run was read as a
    hardware fault. Supply, bridge, module and heat exchanger were all fine.
    The curve was the honest response to a quarter of the commanded drive.
    maxDuty is now 255, so commanded and delivered duty are the same number.
    Safety now rests on the series thermal switch, the temperature channel, and
    not leaving a full-drive heating run unattended, rather than on a software
    limit the operator forgets is there.
    GUI changes for the full-drive re-run:
    - temperature axis widened from 10.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
    [tec_control_run.csv]
2026-09-23 Part 7 at full drive: 70.1 C swing, -16.0 to +54.1 C
    Instructor checked at the bench. 917 rows over 458.5 s, snapshotted out of
    the live CSV as part7_full_drive_70C_swing.csv so a later run cannot
    overwrite the graded evidence.
    37.5 C below ambient and 32.6 C above, so the whole range is the module
    doing work rather than passive drift.
    Heating runs 6.8x faster than cooling, +1.821 against -0.269 C/s. The
    earlier partial-drive run measured 3.7x, and the gap between the two figures
    is the result: Joule heating grows as the square of the current while
    pumping grows linearly, so the asymmetry worsens with drive.
    Also records why the partial-drive attempt was misread as a hardware fault,
    and n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
    [part7_full_drive_70C_swing.csv]
2026-09-23 Part 6: serial command interface verified at Serial Monitor
    The assignment asks for this check before the sketch is paired with Python,
    and it was the one part with no evidence file behind it.
    Confirmed: a valid command names the correct pin (COOL -> pin 9), a
    malformed number is rejected and drops the duty from 40 to 0 rather than
    being silently read as zero, an out-of-range 300 is clamped to 255 rather
    than rejected, and zero duty releases both bridge inputs (pin none).
    Records the sketch identity from the boot banner, since three different
    builds were uploaded in the session and only two banner lines tell them
    apart.
    Two honesty notes in the file. The HEAT acknowledgement scrolled past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
2026-09-23 Part 7 repeated with the corrected sketch: labels finally truthful
    Recovered from the live CSV before the next launch could overwrite it.
    First run in the module whose direction labels match the plate. Commanded
    HEAT rose 26.75 to 53.67 C, commanded COOL fell 52.23 to -6.79 C, a 60.9 C
    swing. Sketch identity confirmed from the boot banner.
    The cooling leg decelerates smoothly to a -6.79 C floor and then REVERSES,
    warming at +0.33 C/s with the duty column still reading 251 on every row.
    That is the module reaching its temperature-difference limit and losing
    ground as its own hot side climbs, not a code fault. Flagged against the
    still-unrecorded heat-exchanger checklist row, since it is the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
    [part7_labeled_run.csv]
2026-09-23 Part 7: integrated manual-control test recorded against all five spec items
    Tests 1, 3, 4 and 5 are written up with the serial captures, CSV and code
    behaviour that back them.
    Test 2, the oscilloscope check of pins 9 and 10, was performed at the bench
    and checked by the instructor, but no captures or numeric readings were
    retained and docs/figures/module_03/ is empty. Recorded as a gap rather than
    reconstructed from memory, with a note of what the check is actually for:
    the idle bridge input must be driven LOW rather than held HIGH, because this
    driver inverts the duty cycle on a high idle input and would turn a
    commanded zero into full drive.
    CSV integrity verified on part7_labeled_run.cs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
    [tec_control_run.csv]
2026-09-23 Module 4 setup: software temperature interlock, working note, plot script
    Arduino: arduino/module_04/tec_open_loop_safety, derived from the Module 3
    control sketch with the measurement, parser and output behaviour unchanged.
    Adds temperatureLimitC = 60.0, checked on every loop pass rather than inside
    the 500 ms reporting block, since a safety check gated by a print statement
    runs at whatever rate you happen to be printing. Averaging 500 samples takes
    about 50 ms, so the limit is now checked around 20 Hz.
    The shutdown LATCHES rather than auto-resuming, because resuming as soon as
    the plate fell back under the limit would turn an over-temperature event into
    an unnoticed oscillation at the saf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
    [steady_state.csv]
2026-09-23 Fix RAM exhaustion that stopped the Module 4 sketch booting
    The sketch printed a few characters of its banner and reset in a loop:
    #39 Mod
    # Phys 39 Mod
    The ATmega328P has 2048 bytes of SRAM and copies every Serial.print string
    literal into it at startup. The safety messages pushed the literal total to
    about 1491 bytes before any variables, the 48-byte line buffers or the
    stack, so the stack collided with the globals and the board reset partway
    through printing its own banner.
    Fixes:
    - all 50 Serial.print literals wrapped in F(), keeping them in flash
    - sensorName moved to PROGMEM and printed via __FlashStringHelper
    - parseSafetyCommand() now tokenizes in place rather than taking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
    [tec_control_run.csv]
2026-09-23 Module 4 Part 1: software shutdown demonstrated, all five requirements
    TEC power off throughout. The limit was lowered below room temperature with
    TEST LIMIT rather than heating the apparatus to 60 C.
    Demonstrated: valid commands select the calibrated pins (HEAT to 10, COOL to
    9), TEST LIMIT 20 trips within one 0.5 s reporting interval, PWM goes 40 to
    0, both bridge outputs are driven LOW, measurement lines continue without a
    gap through the whole shutdown, a drive command sent while latched is
    refused out loud rather than silently zeroed, and CLEAR SAFETY restores the
    60.0 C limit while leaving PWM at 0.
    Also records the unplanned trip earlier the same day: the divider's 100 kOhm
    upper le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
    [tec_control_run.csv]
2026-09-23 Record instructor approval of the high-current wiring, 23 Sept 2026
    Actuator power is approved. Name and time still to fill in.
2026-09-30 Add a one-page Module 4 bench card
    Everything needed at the bench in the order it happens: pre-power checks,
    power-up, exploratory sweep, the ten steady-state points, and what to
    snapshot before leaving.
    Leads with the finger test and the pump check, since those are the two that
    can waste a whole session. The channel sat frozen at exactly 24.27 C for 80
    consecutive reports on 23 Sept, and a frozen channel looks like perfect
    data.
    Carries the Module 3 numbers that set expectations: the 35 s onset delay at
    duty 28, the ~50 s driven time constant behind the 180 s minimum wait, the
    0.079 C quantization step behind the 0.1 C criterion, and the starting
    estimates for maximum useful PWM in each d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
2026-09-30 Pre-power checks completed and verified by the instructor
    Temperature channel confirmed by the finger-response test, so the frozen
    24.27 C reading from 23 Sept was not a stuck channel. Numeric checklist
    values still to be transcribed from the bench notebook.
2026-09-30 Rebuild Module 4 for the revised assignment
    The published assignment differs from the copy pasted earlier, in ways that
    change both the code and the plan.
    Code:
    - sampleCount 500 -> 1000 and report interval 500 -> 1000 ms, since the
    assignment now specifies 1000 averaged samples updating about once a second
    - strip chart temperature axis now autoscales: 1 C past the visible extremes,
    6 C minimum span so noise is not magnified into apparent signal, white
    background. The PWM axis stays fixed. A 0.05 C/s drift decides whether a
    point is steady and is invisible on the old 100 C axis
    - plot script rewritten for SIGNED PWM rather than magnitude, with fitted
    lines over the ranges used, b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
    [plot_open_loop_calibration.py, tec_control_gui.py, tec_open_loop_safety.ino]
2026-09-30 Write the A2 Part 5 derivation, the heaviest item at 3 of 10 points
    Needs no bench data; only the final number waits on r.
    Covers the PWM averaging proof with both integrals evaluated explicitly, why
    <I^2> differs from <I>^2 by exactly a factor 1/D and what that means
    physically, and the consequence that both Peltier and Joule terms are linear
    in duty so the graph should come out straight. That makes the straightness of
    our measured graph a test of the result rather than a decoration.
    Enumerates the direction of every heat flow on both branches, as the
    assignment asks: on heating, Peltier and Joule both deliver heat into the
    object and conduction carries it out; on cooling, Peltier removes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
2026-09-30 Point the GUI's CSV at data/module_04/
    Traces now land with the rest of Module 4's data instead of among Module 3's.
2026-09-30 Widen the strip-chart window to 300 s for Module 4
    The driven time constant measured on the bench is 70 s, so three of them is
    211 s and the observation minute takes a single steady-state point to about
    270 s. The 120 s window inherited from Module 3 would scroll the start of
    each approach off screen before the plateau arrived, and comparing the two is
    how you judge steadiness.
2026-09-30 Module 4 Part 3 complete: ten steady-state points, both slopes, Qj/Qp
    Ten points measured 30 Sept, five per branch, after finding that A0 had been
    wired to the trim pot rather than the thermistor divider junction. Every
    earlier reading this session was a potentiometer.
    m_h = 0.5013 C/count u = 0 to +50 R^2 = 1.0000
    m_c = 0.1809 C/count u = -65 to 0 R^2 = 0.9989
    r = 2.771
    Qj/Qp = (r-1)/(r+1) = 0.470
    The heating branch is linear to one part in a thousand. That is the Part 5
    prediction landing: Peltier follows <I> = DI and Joule follows <I^2> = DI^2,
    both linear in duty, so the susceptibility is constant. Predicting the u = 38
    point from the u = 12 and 25 points gave 40.6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
    [cooling_trace_01.csv, full_run.csv, steady_state.csv, tec_run.csv]
2026-09-30 Make the figure caption say what was actually done
    The old caption claimed every point was waited out to the drift criterion.
    Several were not; they are exponential-fit asymptotes, which steady_state.csv
    records row by row. The caption now says so, and names the measured noise
    floor (0.16 C peak-to-peak), the driven time constant (70 s), T0, and both
    R-squared values.
    [tec_run.csv]
2026-09-30 Restyle the Part 4 figure as an Excel-style scatter with trendlines
    Displays each fit's equation and R-squared on the chart, the way Excel's
    'Display Equation' and 'Display R-squared value' options do, in the series
    colour.
    Presentation only, the numbers are unchanged: white plot area, light grey
    gridlines on both axes, no top or right spine, outward ticks, dark-edged
    markers, dashed trendlines drawn only across the range actually fitted, and
    a 'Linear (series)' legend entry per fit.
    [tec_run.csv]
2026-09-30 Add the Laird comparison calculator, values left blank on purpose
    Takes the four data-sheet quantities and produces Qj_max, Qp_max,
    r_Laird,max and the comparison against our measured r = 2.771, printing the
    units on every line since the rubric asks for a dimensionally clear
    calculation.
    The four constants are None. The assignment forbids getting the numbers from
    an AI before the student has located them, so the machinery is here and the
    values are not. Smoke tested with placeholder numbers, which were not
    committed.
    [tec_run.csv]
2026-09-30 A2 items 4 and 5: Laird values located, interpreted and compared
    Read from the CP14-127-045-L2-W4.5 SPECIFICATIONS table, Th = 27.0 C column:
    R_M 1.50 ohm, I_max 8.6 A, Qc_max 71.3 W at dT = 0, dT_max 70.5 C at Qc = 0.
    Qj_max = 0.5 * I_max^2 * R_M = 55.47 W
    Qp_max = Qc_max + Qj_max = 126.77 W
    r_Laird,max = 2.556
    against measured r = 2.771, so they agree to 8%. Recorded as closer than the
    comparison deserves rather than as a confirmed prediction, with the reasons
    the two conditions differ set out: D = 1 is not I = I_max, chopped current
    versus steady DC, finite dT against the data sheet's dT = 0, temperature
    dependent coefficients, and one slope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
    [tec_run.csv]
2026-09-30 Draft the A2 conclusion; all seven items now written
    146 words, inside the 100 to 150 asked for. Covers what the measurements
    imply about all three mechanisms the item names: linearity as evidence for
    the PWM averages, the sign asymmetry between Peltier and Joule as the origin
    of r, and conduction cancelling from the ratio so it cannot explain unequal
    slopes.
    Every claim traces to a number established earlier in the paper.
    [tec_run.csv]
2026-09-30 Build A2_Naidu_Cohen.pdf, two pages, all seven items
    Generated by python/build_a2_pdf.py so it can be rebuilt if a number changes.
    Page 1: the figure with its steady-state caption, the slopes table with fit
    ranges and R-squared, and the full derivation (PWM averaging with both
    integrals, the steady-state balance with the direction of every heat flow on
    each branch, and the cancellation giving Qj/Qp = (r-1)/(r+1) = 0.470).
    Page 2: the Laird table with each quantity's operating condition, the
    maximum-current calculation with units on every line, the Seebeck
    cross-check, the comparison at 8% with the reasons the conditions differ, the
    passive-conduction argument, and the conclusion.
    Excludes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
    [cooling_trace_01.csv, tec_run.csv]
2026-09-30 Module 5 setup: P controller, gain plan from the Module 4 susceptibility
    python/tec_p_control_gui.py closes the loop. It imports the serial thread,
    parser and port resolver from the Module 4 GUI rather than copying them,
    since those carry fixes for a Qt shutdown race and for the device node
    changing when the cable moves, and two copies would mean fixing each twice.
    The control law is the assignment's eight steps. The 1000-sample average is
    already the Arduino's, so the GUI never sees a raw ADC reading. One control
    update per measurement, about 1 Hz, since there is no point computing a
    command more often than the measurement behind it.
    Division of authority: Python decides what to ask for,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
    [droop.csv]
2026-09-30 Make the P-control window readable, and have it predict the settling point
    The first version inherited macOS dark mode while the plots were white,
    which made it hard to read. The window now forces a light palette to match
    the plots, and the readouts are big numbers over small grey captions rather
    than one long run-on line.
    The error tile is coloured by sign, red below setpoint and blue above, and
    the direction tile matches the trace colours.
    The loop-gain banner now also prints where the run should settle: L, a plain
    word for whether that is weak, comparable or strong feedback, the predicted
    droop in degrees, and the expected steady temperature. That turns the banner
    from a restatement of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
    [p_control_run.csv]
2026-09-30 Module 5 Part 3 complete: droop measured at six gains, model confirmed
    Setpoint 30.0 C, e0 = 8.46 C, six gains from Kp 0.25 to 8.00 giving L from
    0.125 to 4.010. All six settled by the drift criterion, net change over the
    final 60 s no larger than the 0.16 C noise floor, and T_ss taken as the mean
    of that minute.
    mean measured/predicted droop ratio 1.003, sd 0.017, worst point 2.6% off
    The prediction came from the Module 4 susceptibility before any of these
    runs and was not fitted to them.
    At Kp = 2.00, L = 1.003, the measured droop is 4.25 C of an 8.46 C initial
    error, so 50.2% survives against a predicted 50%.
    Two results the graph does not show. The commanded PWM equals Kp*droop at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
    [droop.csv, kp_0p25_run.csv, kp_sweep_full_run.csv]
2026-09-30 Restyle the droop figure as a spreadsheet chart with the agreement quoted
    Same convention as the Module 4 figure: white plot area, light grey
    gridlines on both axes, no top or right border, outward ticks, dark-edged
    markers, and the model statistics printed on the chart the way Excel writes
    a trendline equation and R-squared.
    The box quotes chi with a note that it came from Module 4 and was not fitted
    here, R-squared 0.9974, and the mean measured/model ratio with its spread
    and worst deviation, since a ratio says more about a one-parameter-free
    prediction than R-squared alone does.
    L = 1 marked with a star at Kp = 1.99, where exactly half the initial error
    survives. It is the most quotable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
    [p_control_run.csv]
2026-09-30 Match the droop figure to the Module 4 figure's plain style
    Removed the boxed stats callout, the starred L=1 marker, the open triangles
    for the model evaluated at each gain, and the four-entry legend. What is
    left is what the Module 4 figure does: dashed model line, dark-edged
    markers, the equation and R-squared as plain coloured text at the top left,
    and a two-entry legend.
    Kept the secondary L axis, since the loop gain is the quantity the physics
    depends on and Kp is only how it is dialled in. That is information rather
    than decoration.
    [p_control_run.csv]
2026-09-30 Module 5 Part 2: sign test passes in both directions
    3064 samples of positive error all reported HEAT, 394 samples of negative
    error all reported COOL.
    One sample at the setpoint change reports a negative error with direction
    HEAT. That is the Arduino echoing the previous command before its next
    report, one sample of pipeline delay in a 1 Hz loop, not a sign error. It is
    written up rather than filtered because an automated check on the logged file
    flags it and the explanation is the useful part.
    Records that the same Kp = 0.25 gives L = 0.125 heating but only 0.045
    cooling, a 2.77x weaker loop for an identical gain, so the Module 4
    susceptibility asymmetry propagates directly into the feed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
    [sign_test_and_sweep.csv]
2026-09-30 Module 5 Part 5: no oscillation to L = 8, and feedback quiets the output
    Kp = 16, L = 8.02, settled at 29.096 C against 29.062 predicted, held 17
    closed-loop time constants with a final-30 s spread of 0.020 C. No
    overshoot, no oscillation, no saturation, PWM peaked at 27.
    At L = 8 the closed-loop time constant is 7.8 s against a 1 s sampling
    interval, so the controller is acting faster than the plate carries heat from
    the TEC face to the thermistor. That is where lag-driven overshoot would
    appear. It did not, so the lag here is short compared with 7.8 s and the
    one-lump model remains adequate across the whole range tested.
    Unplanned result recorded: the open-loop channel showed 0.16 C peak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
    [kp16_high_gain_run.csv]
2026-09-30 Finish the Module 5 note: L table, gain classification, evidence ticked
    Part 6 item 3 filled in with all seven gains: measured fractional droop
    against 1/(1+L), mean ratio 1.00 with sd 0.02 and no trend in the residuals.
    Records which runs genuinely have small gain, which is what the question
    asks: only Kp = 0.25 and 0.50, where L < 0.3 and over 80% of the initial
    error survives. It also notes the classification cannot be made from Kp
    alone, since the same Kp gives an L 2.77x smaller when cooling.
    Notes that the scatter tracks the noise floor divided by the droop, from 2%
    at the largest droop to 18% at the smallest, so the highest-gain points are
    the least precisely determined even though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
    [p_control_run.csv]
2026-09-30 Add a Rescale button and make the time axis self-healing
    pyqtgraph disables auto-ranging the moment a plot is scrolled or dragged, so
    one stray trackpad gesture strands the view where there is no data and the
    axis label goes to something like 'Time (e27s)'. Recovering needed the
    right-click menu, which is not obvious mid-run.
    The time axis is now pinned to the rolling window on every redraw, so a
    stray scroll corrects itself within a second, and a plain Rescale button
    next to STOP re-enables auto-range on all three plots for anything the
    redraw does not catch. STOP stays the only red control.
    [p_control_run.csv]
2026-09-30 Module 5 Part 5: Kp = 32 settles cleanly at L = 16, still no oscillation
    T_ss 29.530 against 29.504 predicted, held 16 closed-loop time constants,
    final 30 s spread 0.020 C. Zero direction reversals across all three
    high-gain runs: the command never flipped from heating to cooling.
    Records honestly that saturation was NOT reached and why. Each gain was
    entered from the previous gain's steady state, so at Kp = 32 the run began
    0.91 C from setpoint and the first command was 29 counts. From ambient the
    same gain would ask for 271 and clamp at 255 until the error fell below
    7.97 C, which is a different experiment because the loop is nonlinear while
    clamped and 1/(1+L) does not apply. Identified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
    [kp32_high_gain_run.csv]
2026-09-30 Recover the Module 4 cooling trace, which had been overwritten
    cooling_trace_01.csv was clobbered down to four rows: the snapshot command
    was run again at a moment when the GUI had just restarted and the live
    tec_run.csv held only a header plus three samples. The clobbered version was
    then committed. Recovered the 753-row original from commit 878f43f.
    Removed the leftover four-row data/module_04/tec_run.csv so nothing in that
    folder is live any more; the GUI writes to data/module_05/ now.
    The loss was survivable because full_run.csv holds the complete sweep with
    both branches, but the failure mode is worth naming in the folder README:
    snapshot immediately after a run, and check the row cou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
    [cooling_trace_01.csv, p_control_run.csv, tec_run.csv]
2026-09-30 Close out the Module 4 note: checklist confirmed, results filled in
    The Part 1 pre-power checklist rows are marked confirmed at the bench and
    checked by the instructor: wire gauge on all three high-current runs, spade
    crimps, thermal-switch continuity and its placement in series, and which of
    the two panel supplies feeds B+/B-.
    Three of those were confirmed without the numeric value being written down,
    the supply voltage, the continuity reading and the switch rating. Recorded
    as exactly that rather than as complete, since a checklist that says
    'confirmed' without a reading is weaker evidence than one carrying the
    number. Two minutes with a meter next session closes it.
    Also filled in every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
    [p_control_run.csv]
2026-09-30 Close out the Module 4 note: checklist confirmed, results filled in
    Part 1 pre-power checklist rows marked confirmed at the bench and checked by
    the instructor: wire gauge on all three high-current runs, spade crimps,
    thermal-switch continuity and its placement in series with the TEC, and
    which of the two panel supplies feeds B+/B-.
    Three were confirmed without the numeric value being written down: the
    supply voltage, the continuity reading and the switch rating. Recorded as
    exactly that rather than as complete, since a row saying 'confirmed' without
    a reading is weaker evidence than one carrying the number.
    Filled in every results row still marked 'to record' whose value was already
    estab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
2026-09-30 Stop tracking the live GUI output files
    data/module_05/p_control_run.csv and data/module_04/tec_run.csv are rewritten
    on every launch, so each commit was thousands of lines of churn duplicating
    whatever snapshot had been taken from them. The named snapshots are the
    evidence; these two are scratch.
    [p_control_run.csv]
2026-10-04 Rebuild A2 in the A1 house style and move it into docs/
    Match A1_Naidu_Cohen.pdf: DejaVu Serif throughout, a metadata block under
    the title, plain black numbered headings, grid tables with a grey header
    row, and an n / N footer. Cut the editorial asides and fit the seven
    required items onto two pages.
    Reshape the Module 4 figure wide and short so it stays legible at full
    text width, and move its steady-state criterion into the caption.
    [build_a2_pdf.py, plot_open_loop_calibration.py]
2026-10-05 Rebuild A2 for the restructured assignment
    The course page now asks for six numbered sections using its own headings
    and drops the 100 to 150 word conclusion. Rename the sections to match,
    add the heat-flow direction for each term, the choice-of-fit-range
    reasoning, the data-sheet table citation, and the intermediate
    substitutions. Due date moves to Wednesday 7 October.
2026-10-05 Module 5: add the strip-chart trace figure and record the Kp=32 overshoot
    The evidence list asks for low- and high-gain traces as figures, not raw
    CSV. plot_p_control_traces.py cuts both panels out of the one sweep log.
    Reading the Kp=32 trace properly shows a 0.041 C overshoot at t=7 s,
    twice the 0.020 C noise floor and absent at every lower gain. The note
    previously claimed no overshoot at any gain; corrected, and flagged for
    Module 6 since the one-lump model forbids it.
    [plot_p_control_traces.py]
2026-10-05 Restyle the P-control trace figure to match the other figures
    White plot area, grey gridlines, no top or right spine, the numbers as
    plain coloured text at the top left, plain legend, grey note beneath.
    Add the 1/(1+L) predicted droop alongside the measured value on each
    panel.
2026-10-05 Module 6 Part 3: estimate the open-loop time constant
    Fit every constant-command step in the Module 4 log to an exponential
    rather than reading 63% off one trace, since several steps were stopped
    before they arrived and the 63% line would be drawn against a guess.
    tau = 62.9 +/- 5.0 s over eight steps, all with R^2 > 0.998. The 63%
    method on the fitted asymptotes gives 59.8 +/- 4.7 s, and the zero
    command passive decay alone gives 65.8 s. No scipy needed: the model is
    linear in the two amplitudes at fixed tau.
    [estimate_tau.py]
2026-10-05 Show the tick marks on the shared time axis of the trace figure
2026-10-05 Use the fitted time constant consistently in the module notes
    The notes carried three different numbers: 146 s from Module 3, a 70 s
    working estimate, and now 62.9 +/- 5.0 s from the fits. The Module 3
    figure predates the A0 wiring fix, so it is marked superseded, and the
    closed-loop time constants in the Module 5 note are recomputed from the
    fitted value.
2026-10-05 Module 6 Parts 4, 5 and 7: our own one-lump simulator
    Euler integration of C dT/dt = Pu*u - H(T - T_amb), written in the two
    parameters we actually measured, chi = Pu/H and tau = C/H, so no run
    needs C, H or Pu separately. The PI damping ratio comes out the same
    way: zeta = (1 + chi*Kp) / (2*sqrt(tau*chi*Ki)).
    Part 4 open loop lands within 0.02 C of both a driven and a passive
    measured step, rms residual 0.15 and 0.09 C, with nothing fitted.
    Part 5 reproduces the Module 5 droop across eight gains, 0.98 to 1.03
    of measured. Part 7 shows integral action removing the droop and the
    overshoot appearing exactly where zeta crosses 1.
    Windup needed a note: holding 45 C takes 47 of the 255 availabl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
    [simulate_one_lump.py]
2026-10-05 Module 6 note: Parts 1 to 8 and the cross-check against the supplied program
    Part 6 works the eigenvalue out and names thermal lag as the extension
    most likely responsible for the Kp=32 overshoot, on the grounds that it
    appears only once tau_cl falls from 7.0 to 3.7 s, putting the lag
    between about 4 and 7 s.
    Part 8 answers the four windup questions with the numbers from both
    simulators. Section 9 records that the supplied program reproduces every
    value from our own, including 312 s of clamping against our 313 s.
2026-10-05 Module 5: close three gaps in the interpretation section
    Add the directional-susceptibility relation the derivation hint asks
    for, and the point it exposes: a single Pu predicts the heating and
    cooling magnitudes to be equal, while ours differ by 2.77, which is the
    Module 4 Peltier/Joule asymmetry showing up again.
    Explain the 2 to 3% scatter against 1/(1+L) rather than just reporting
    it; the steady-state criterion alone is 1.9% of e0.
    Point the first-order section at the Kp=32 overshoot, which the single
    real eigenvalue forbids.
2026-10-05 Module 5 audit against the course page: three corrections
    Part 1 asks for an average of about 1000 raw readings. sampleCount was
    cut 1000 -> 500 on the morning of 30 September, before any Module 5 data
    was taken, so every run averages 500 and reports at 1.97 Hz, not the
    1000 and 1 Hz the note claimed. Recorded as a deviation rather than
    quietly corrected, since the data cannot be retaken without the bench.
    Part 3's specified table has a Predicted P0 column we never tabulated.
    Added, with P0/P_required, which shows the range spans 0.13 to 16 times
    P_required and crosses 1 at Kp = 2.
    Part 5's specified table has Period and Frequency columns. Added as n/a,
    with the reason stated.
    Also record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
2026-10-05 Module 6 audit against the course page: four gaps closed
    Part 6 lists seven candidate extensions; the note addressed four. All
    seven are now taken in turn, and the choice of a second thermal mass is
    argued from the open-loop residuals rather than the overshoot alone,
    since those traces contain no controller and so rule out discrete
    sampling as the cause of their structure.
    Part 7 asks for C, H and Pu recorded for one overdamped and one
    underdamped set. Tabulated, with H = 1 W/K chosen so the other two read
    straight off, and the agree/disagree verdict the module asks for.
    The A3 preservation list asks for residuals, initial conditions, the
    saturation limit and the exact run command. Residua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
    [simulate_one_lump.py]
2026-10-05 Stop overclaiming the fit quality in Modules 4 to 6
    Four fixes, prompted by the observation that the data looks too good.
    Quote rms residuals alongside honest R squared: 0.010 C over a 25 C span
    heating, 0.138 C over 11.8 C cooling. R squared = 1.0000 was a four
    decimal rounding of 0.999999 and reads as fabricated. The 14-fold
    difference between branches is the predicted Peltier/Joule asymmetry.
    State what the R squared measures: eight of ten Module 4 steady-state
    points are fitted asymptotes, so it measures the apparatus and the
    quality of those fits together. The extrapolation is 0.5 to 3.6 percent
    of each step, which is defensible, but it has to be said.
    Name the shared-fit dependence: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
2026-10-05 Audit Modules 3 to 6 against the raw logs and the data sheet
    Every reported value re-derived from raw data. Corrections:
    Data preserved
    - data/module_05/session_2026-09-30_full_log.csv: the complete 30 Sep
    session log, copied from the GUI's live file, which is overwritten on
    every launch. Values unchanged; Git stores it with LF line endings where
    the GUI wrote CRLF. The kp_*_run.csv files are prefixes of it and stop
    partway through.
    Module 5
    - Kp = 8 steady state 28.33 -> 28.43. The old value was the final minute
    of a snapshot taken 114 s into a 278 s run; the plate rose a further
    0.1 C. Ratio to model 0.989 -> 0.930.
    - Kp = 4: 27.18 -> 27.19, the mean rather than the modal rea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
    [droop.csv, session_2026-09-30_full_log.csv, steady_state_from_raw.csv]
2026-10-05 Add the supplied-simulator screenshots; record the Kp=32 and heat-50 answers
    Module 6 section 9 now carries six screenshots of the supplied P/PI
    program run with our parameters (C 62.9 J/K, H 1 W/K, Pu 0.5013 W/count,
    Kp 2), each captioned with its settings and the values it reports. The
    program's default-parameter run is left out. The difference between its
    anti-windup and ours is explained from both programs' code: it refuses an
    integral step that would saturate the command, ours holds the integral
    once the command is already saturated.
    Kp = 32: the run ends at about 216 s because the 12 V actuator supply was
    switched off at the end of the session; the Arduino, on USB, kept
    logging. Recor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
2026-10-13 Add the PI control GUI and the Module 6 sketch with 1000-sample averaging
2026-10-13 Add October 13 TEC PWM analysis
2026-10-14 Module 6 Part II: capacitance-split extremes
2026-10-14 Module 6 Part II: tighten the period statement
2026-10-19 Module 6 oral review: board derivation, Goldilocks and parameter questions, foam-removal experiment design; steady operating points and sensitivity script
2026-10-26 Module 7: rod multichannel sketch and logger (synchronized, PI base control), calibration, step-response and stationary-fin analysis, rod-instrument and fin notes, Part I theory notes
2026-10-26 Rod instrument note: rod material and nominal geometry
2026-10-26 Rod calibration: multi-point (several plateaus) offset and gain per channel
2026-10-26 Rod calibration: room-air cross-check of the 26 Oct bundle (reference = mean of the rod channels)
2026-10-26 Rod logger: keep logging rod channels when the base reading is unusable (base columns blank); switch control off if that happens while on
2026-10-26 Rod runs of 26 Oct (raw) and the room-temperature cross-check from 150-390 s of rod_run_20261026_112627 after the loose wire was fixed
2026-10-28 Module 7: measured sensor spacing (1 in, +/-1 mm), fin fit redone
2026-10-28 Fin fit: mark the farthest hole on the profile figure
2026-10-28 Module 7: placement calculation (why 1/e is out of reach, how to place sensors)
2026-10-28 Add Sammy Module 7 rod instrument copy
2026-10-28 Analyze Sammy Module 7 rod fin run
2026-10-28 Add TEC base sensor rod run analysis
2026-11-02 Module 8: Angstrom sketch (setpoint, PI and cooling ratio on the Arduino), live GUI with logger import, P3 notes
2026-11-02 Sensor map: sensors back at 1 in spacing on 2 Nov (T1-T5 = R1-R5)
2026-11-02 Rod geometry: caliper diameter, T1-to-top and overall length (2 Nov)
2026-11-02 Module 8: feedforward and actuator checks, finite-length check, geometry confirmed, README section
2026-11-02 A5: Angstrom derivation and model-validity plan (source), finite-rod fit script
2026-11-04 Module 8 Stage 3: frequency schedule on the Arduino (SCHED commands), GUI schedule box with fast-test and production presets
2026-11-04 S19: raw start-up files (wiring faults, reseat) and bench record
2026-11-04 A4: finite-rod model and validity checks (source)
2026-11-04 Runbook: caliper check of sensor spacing before the production run
2026-11-11 Add Sammy Module 8 Angstrom acquisition copy
    Sketch and GUI copied from Kapil Naidu's Module 8 files (ab5cb3f, 60500c8), which are unchanged. Adds a RAW sinusoidal-PWM mode (S18.3, S18.4), a step counter for live runs, a Sammy data folder and two schedule presets. Compiled for the Uno and tested on a host simulation; not yet run on the bench. Written with GitHub Copilot assistance.
2026-11-11 Packet draft: cite rho and c (ASM/MatWeb 6061-T6), rod vertical
2026-11-11 Add Sammy Module 8 S18.3 raw-PWM run, analysis, step-by-step walkthrough, figures and GUI photos
    Run sammy_angstrom_live_20261111_122227 (u = 50 sin, U0 = 0, 100/200/500 s). Walkthrough and analysis produced with GitHub Copilot assistance.
2026-11-11 Add Sammy Module 8 S18.4 positive-only PWM page and prediction script; S18.3 page links to it
    Predictions come from the S18.3 one-lump fit and the 10 Nov PI hold (U0 = U = 36 counts for a 40 C mean); no S18.4 data exist yet. Page, script and figures produced with GitHub Copilot assistance.
